Athul24milu/ESPFC-WHOOP-/02_Guides/ESP_FPV_ATHUL_Component_Map_L4.pdf

# TOP ASSEMBLY / ALL COMPONENTS

## 23 FOOTPRINTS ON THIS SIDE

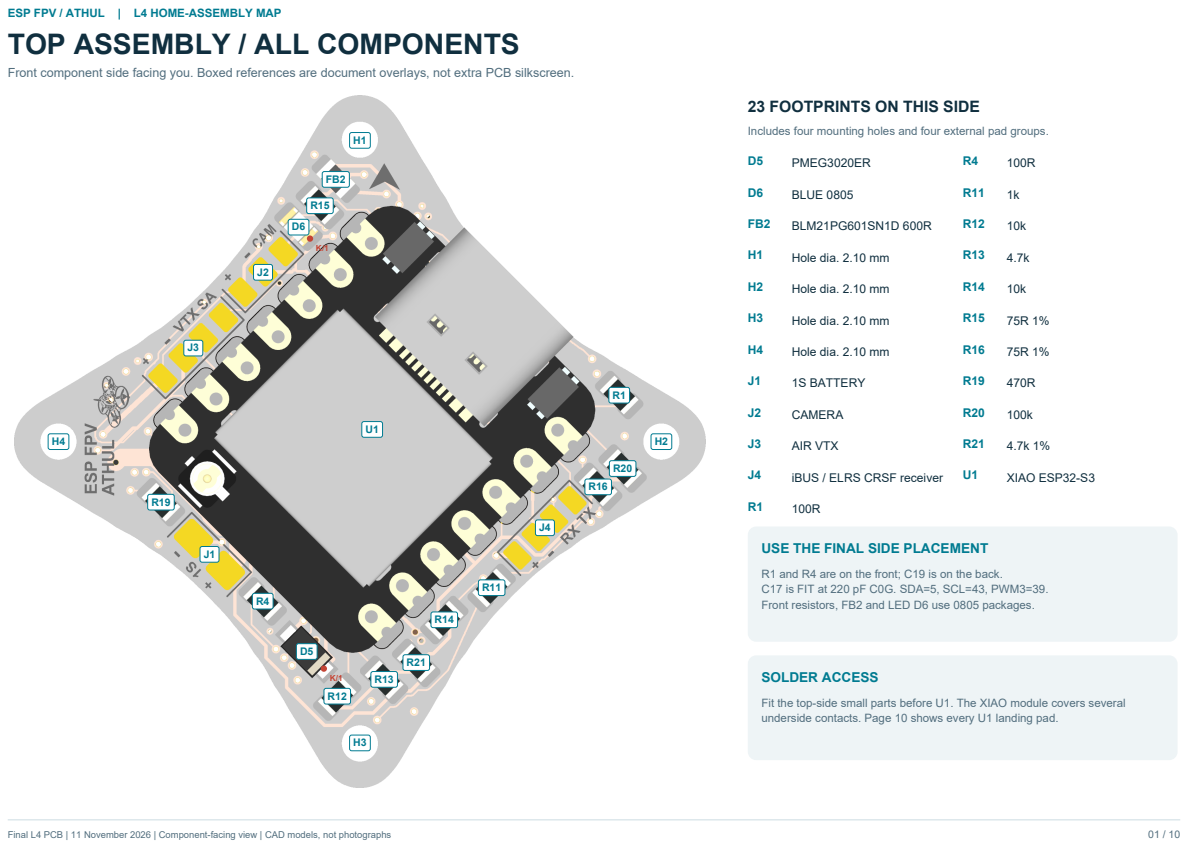
[picture p2: page 1]

ESP FPV / ATHUL | L4 HOME-ASSEMBLY MAP

Front component side facing you. Boxed references are document overlays, not extra PCB silkscreen.

Includes four mounting holes and four external pad groups.

USE THE FINAL SIDE PLACEMENT

R1 and R4 are on the front; C19 is on the back.
C17 is FIT at 220 pF C0G. SDA=5, SCL=43, PWM3=39.
Front resistors, FB2 and LED D6 use 0805 packages.

Fit the top-side small parts before U1. The XIAO module covers several
underside contacts. Page 10 shows every U1 landing pad.

# BOTTOM ASSEMBLY / ALL COMPONENTS

## 52 FOOTPRINTS ON THIS SIDE

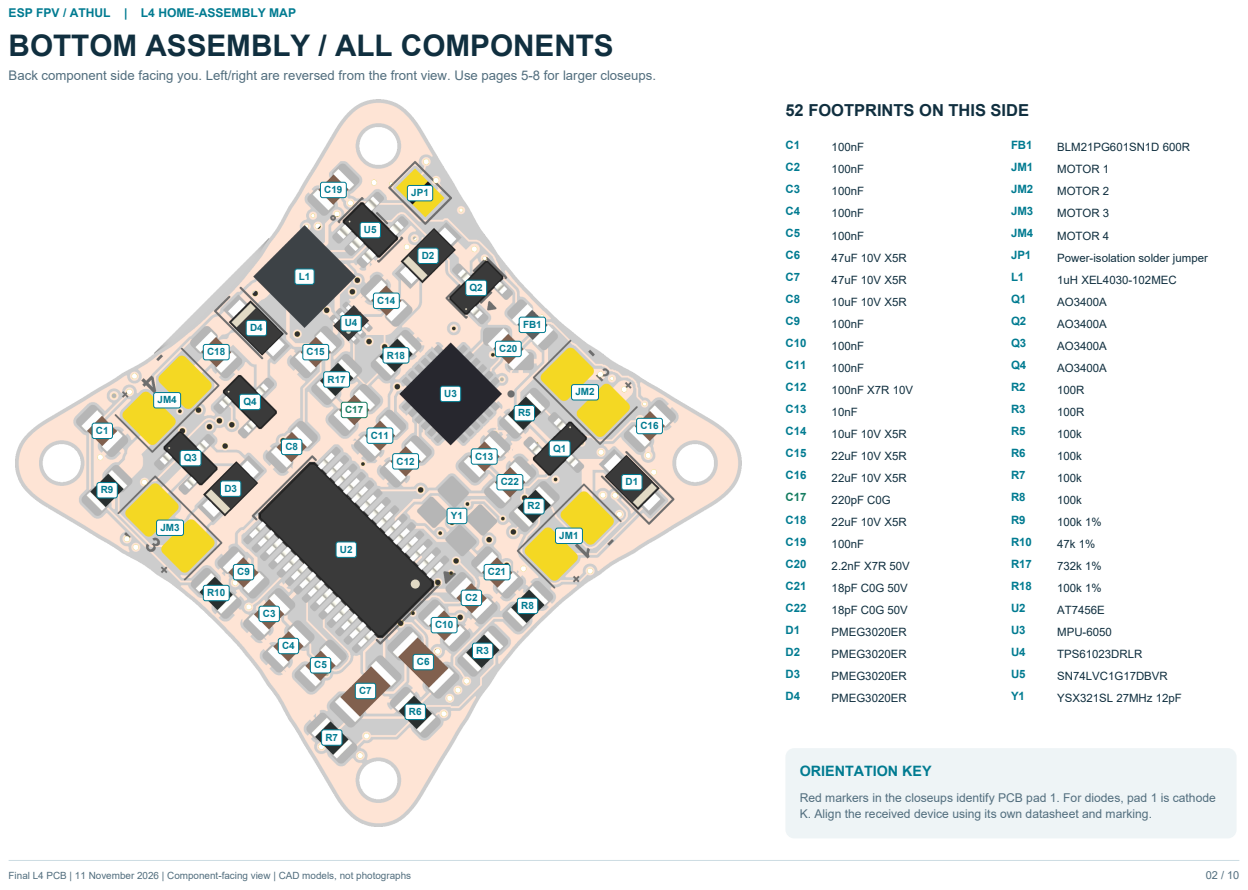
[picture p3: page 2]

Back component side facing you. Left/right are reversed from the front view. Use pages 5-8 for larger closeups.

Red markers in the closeups identify PCB pad 1. For diodes, pad 1 is cathode
K. Align the received device using its own datasheet and marking.

# BATTERY, CAMERA, VTX & RECEIVER / EXACT PADS

Front side facing you. Follow each colored leader to the center of the named pad.

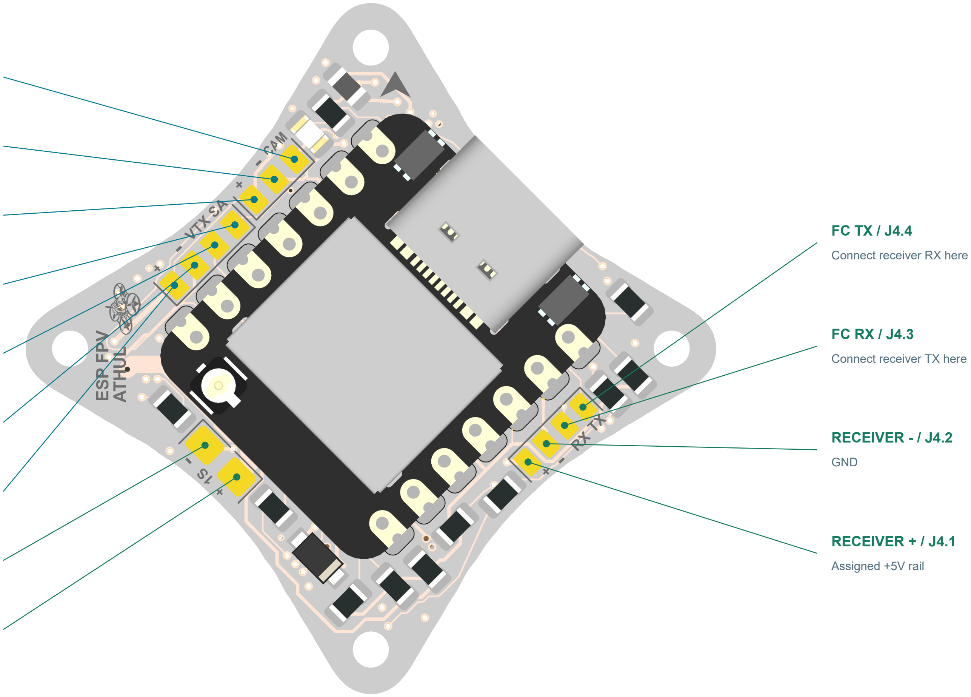
[picture p4: figure]
Connect receiver RX here; Connect receiver TX here; RECEIVER - / J4.2; GND; RECEIVER + / J4.1; Assigned +5V rail

Final L4 PCB | 11 November 2026 | Component-facing view | CAD models, not photographs | 03 / 10

CAM VIDEO / J2.3

Camera video -> OSD input

CAM - / J2.2

GND

CAM + / J2.1

Assigned +5V rail

SA / J3.4

SmartAudio

VTX VIDEO / J3.3

OSD video output

VTX - / J3.2

GND

VTX + / J3.1

Assigned +5V rail

BATTERY - / J1.2

GND

BATTERY + / J1.1

1S input / VBAT

POWER AND UART

J1 takes the 1S battery. J2/J3/J4 positive pads are on the regulated +5V rail: use 5V-compatible modules. Receiver TX -> FC RX, receiver RX -> FC TX. Battery disconnected for initial USB programming.

# MOTORS & POWER JUMPER / EXACT PADS

Back side facing you. Motor negative is a switched MOSFET return - it is not GND.

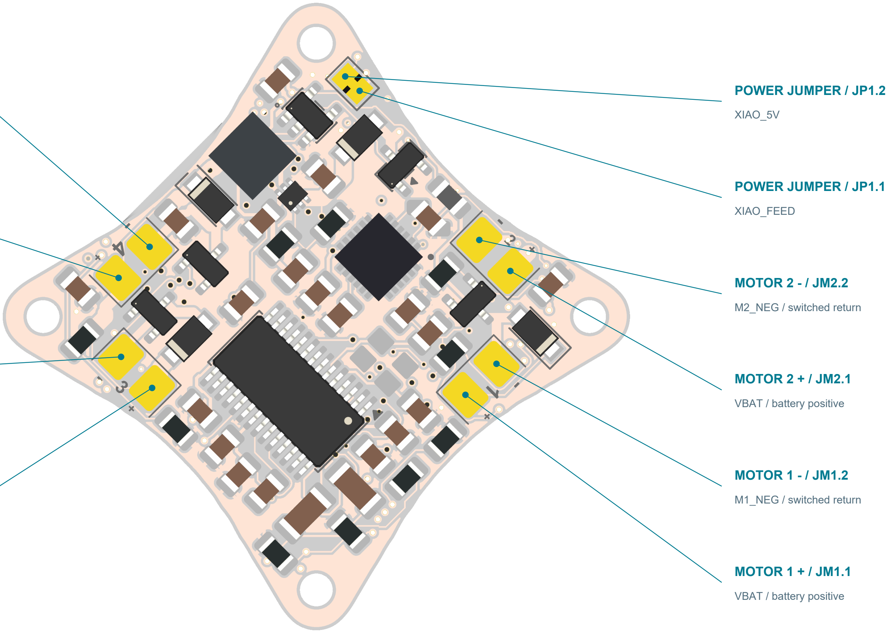
[picture p5: figure]
POWER JUMPER / JP1.2; XIAO_5V; POWER JUMPER / JP1.1; XIAO_FEED; MOTOR 2 - / JM2.2; M2_NEG / switched return; MOTOR 2 + / JM2.1; VBAT / battery positive; MOTOR 1 - / JM1.2; M1_NEG / switched return; MOTOR 1 + / JM1.1

Final L4 PCB | 11 November 2026 | Component-facing view | CAD models, not photographs | 04 / 10

MOTOR 4 - / JM4.2

M4_NEG / switched return

MOTOR 4 + / JM4.1

VBAT / battery positive

MOTOR 3 - / JM3.2

M3_NEG / switched return

MOTOR 3 + / JM3.1

VBAT / battery positive

JP1 AND MOTOR NUMBERING

JP1 is closed for battery flight operation; open it for simultaneous USB + battery use as marked in the design. Verify its bridge state with continuity. Motor numbers are PCB labels; the firmware mixer and spin directions still need setup.

# BOTTOM CLOSEUP / UPPER LEFT

## 14 REFERENCES IN THIS REGION

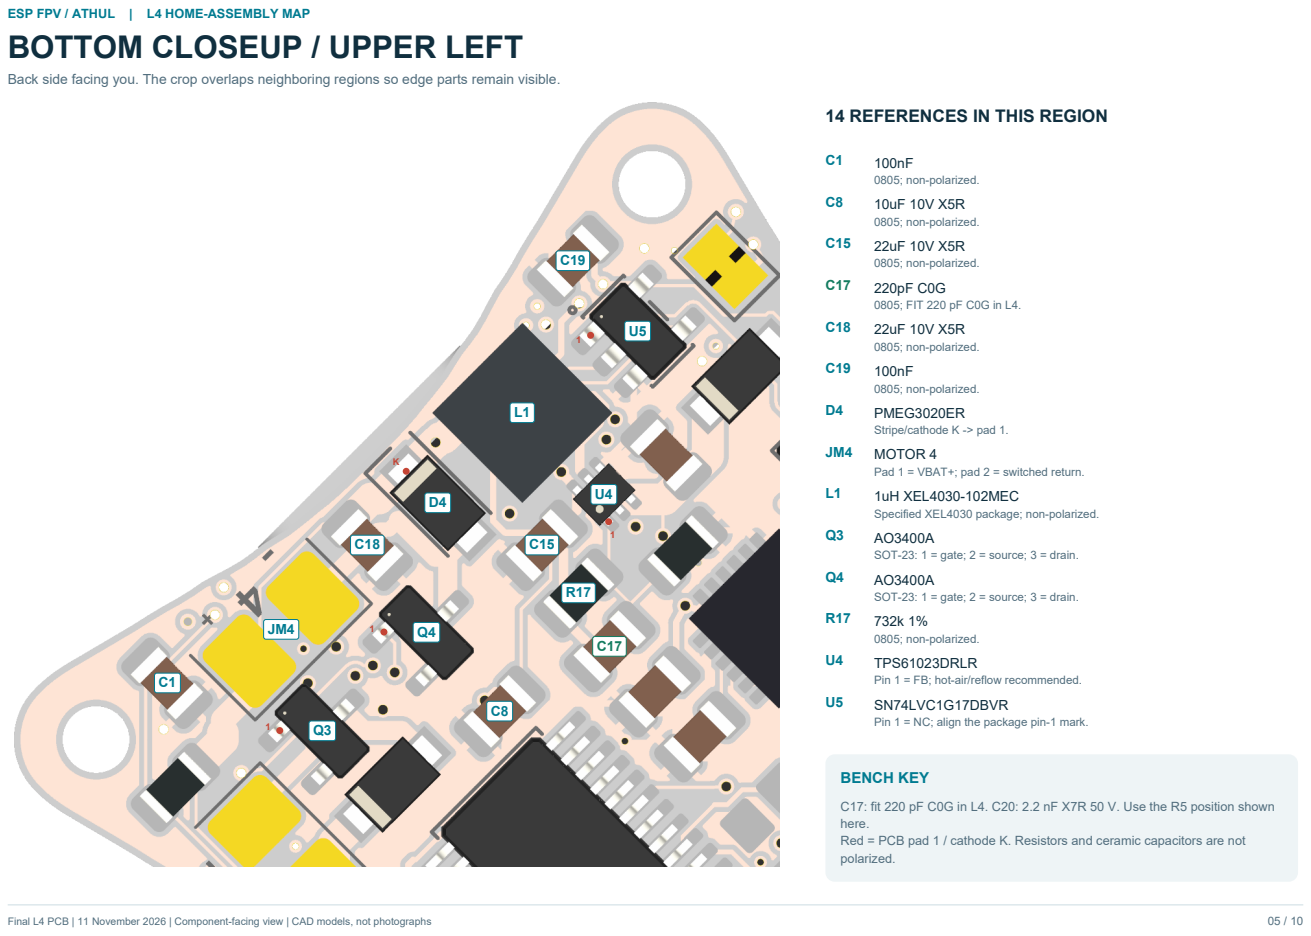
[picture p6: page 5]

Back side facing you. The crop overlaps neighboring regions so edge parts remain visible.

Pad 1 = VBAT+; pad 2 = switched return.

Specified XEL4030 package; non-polarized.

SOT-23: 1 = gate; 2 = source; 3 = drain.

Pin 1 = FB; hot-air/reflow recommended.

Pin 1 = NC; align the package pin-1 mark.

C17: fit 220 pF C0G in L4. C20: 2.2 nF X7R 50 V. Use the R5 position shown
here.
Red = PCB pad 1 / cathode K. Resistors and ceramic capacitors are not
polarized.

# BOTTOM CLOSEUP / UPPER RIGHT

## 15 REFERENCES IN THIS REGION

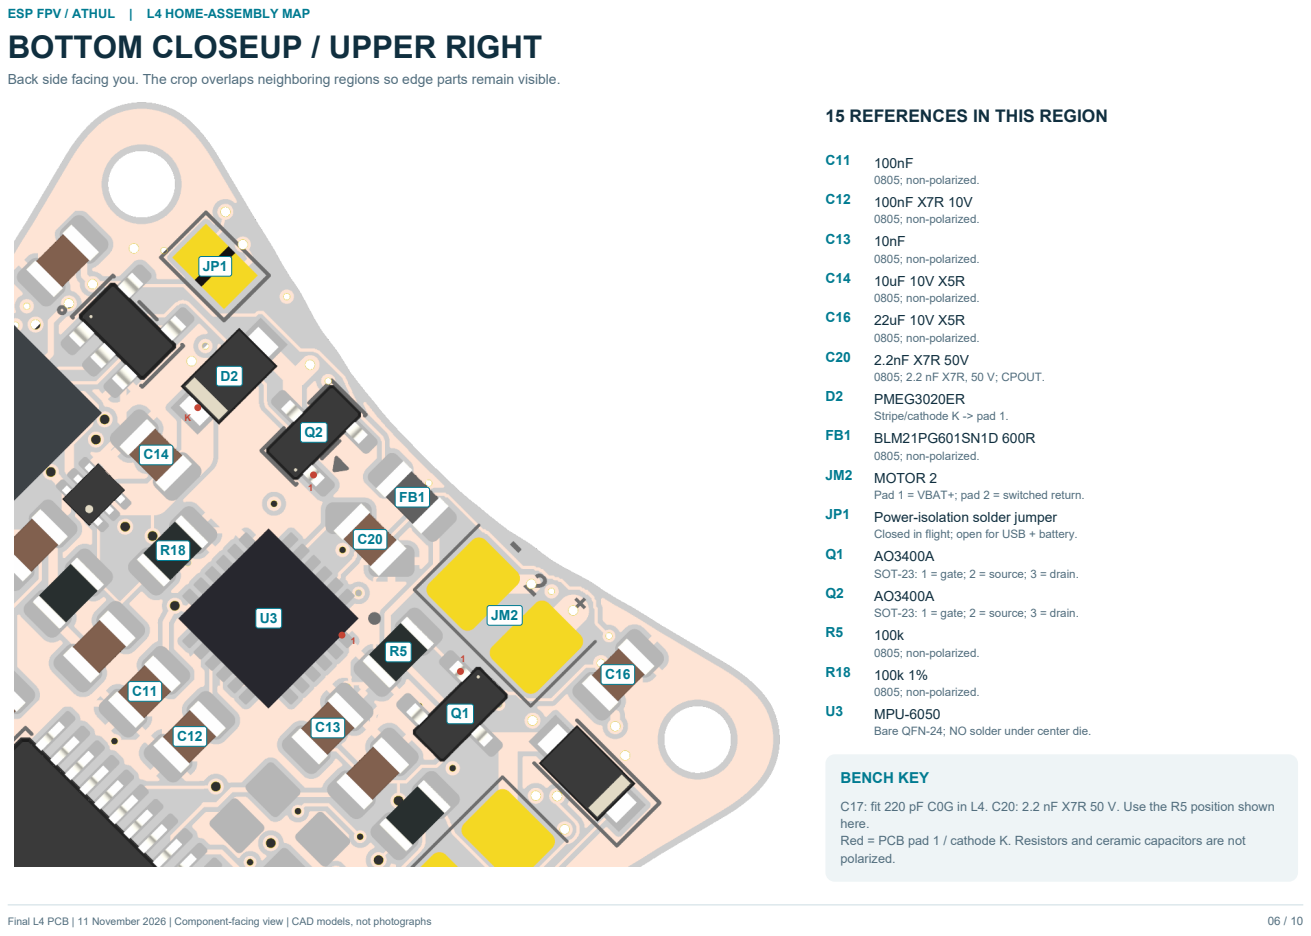
[picture p7: page 6]

Back side facing you. The crop overlaps neighboring regions so edge parts remain visible.

Pad 1 = VBAT+; pad 2 = switched return.

Closed in flight; open for USB + battery.

SOT-23: 1 = gate; 2 = source; 3 = drain.

Bare QFN-24; NO solder under center die.

C17: fit 220 pF C0G in L4. C20: 2.2 nF X7R 50 V. Use the R5 position shown
here.
Red = PCB pad 1 / cathode K. Resistors and ceramic capacitors are not
polarized.

# BOTTOM CLOSEUP / LOWER LEFT

## 11 REFERENCES IN THIS REGION

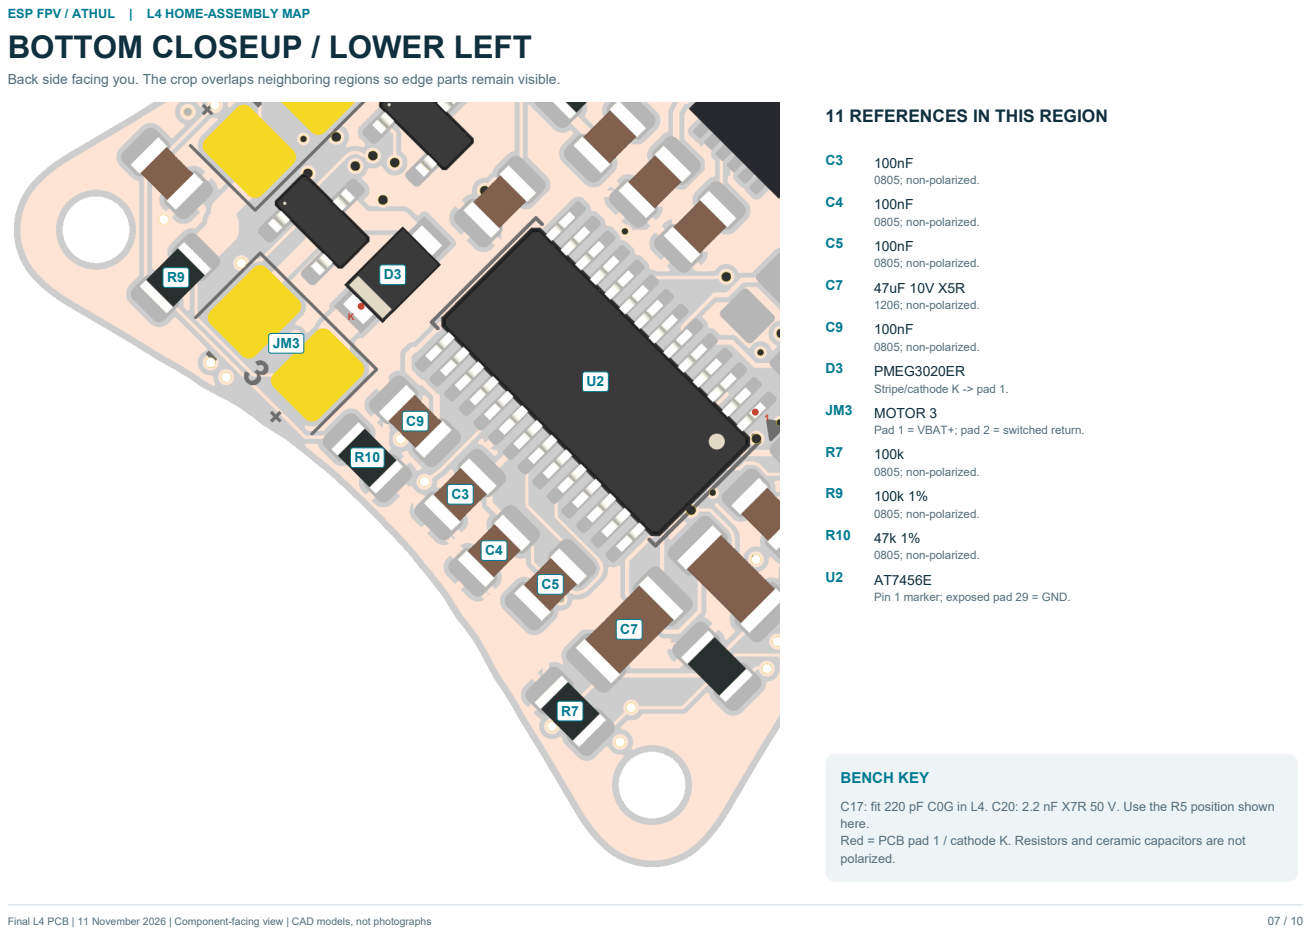
[picture p8: page 7]

Back side facing you. The crop overlaps neighboring regions so edge parts remain visible.

Pad 1 = VBAT+; pad 2 = switched return.

Pin 1 marker; exposed pad 29 = GND.

C17: fit 220 pF C0G in L4. C20: 2.2 nF X7R 50 V. Use the R5 position shown
here.
Red = PCB pad 1 / cathode K. Resistors and ceramic capacitors are not
polarized.

# BOTTOM CLOSEUP / LOWER RIGHT

## 12 REFERENCES IN THIS REGION

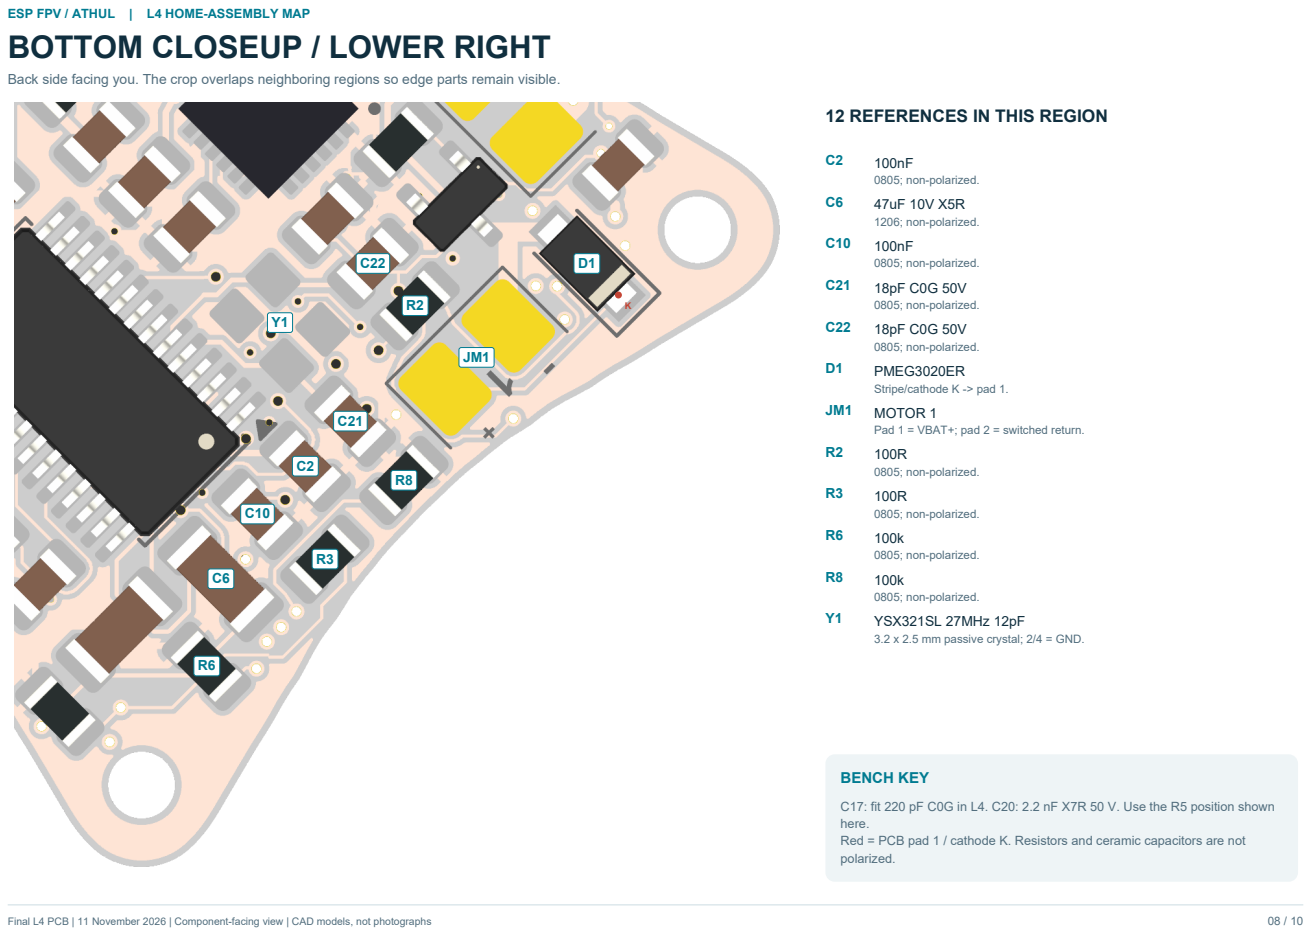
[picture p9: page 8]

Back side facing you. The crop overlaps neighboring regions so edge parts remain visible.

Pad 1 = VBAT+; pad 2 = switched return.

3.2 x 2.5 mm passive crystal; 2/4 = GND.

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

# ORIENTATION / ALIGN THE REAL PACKAGE

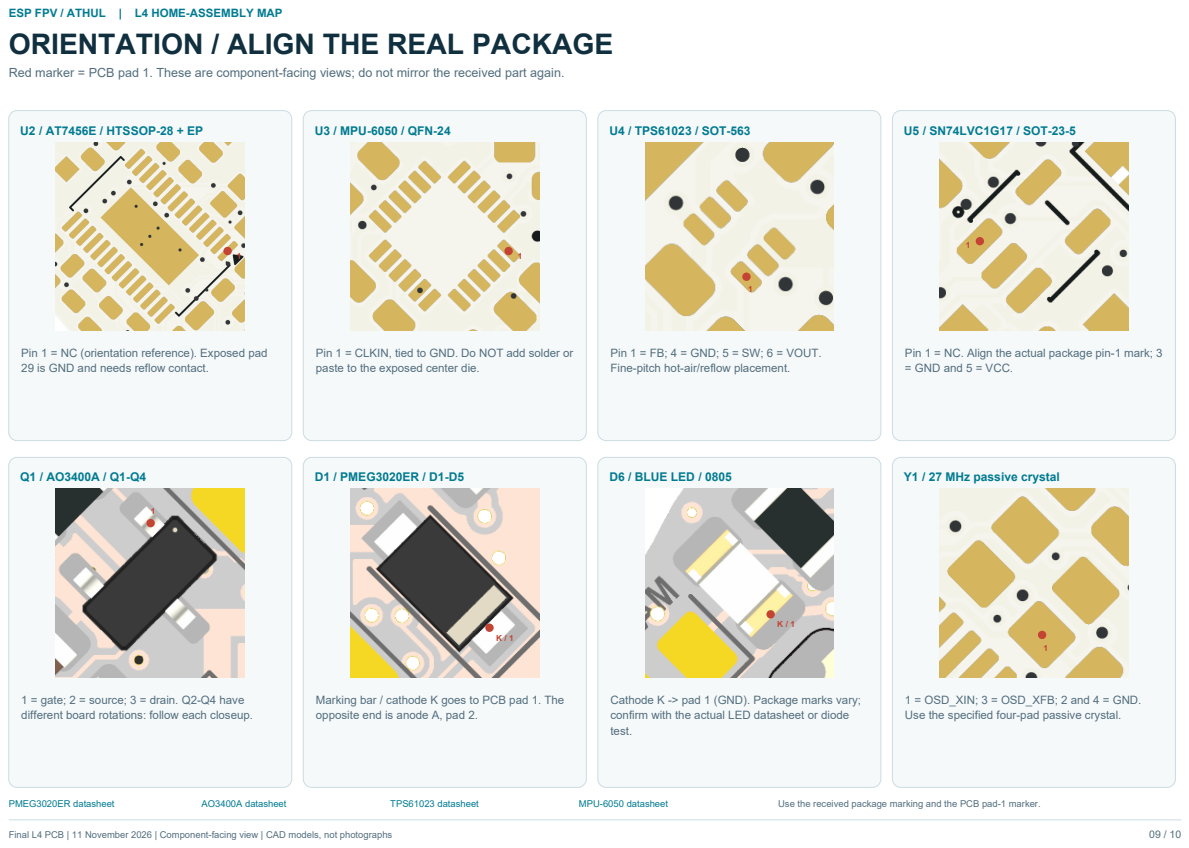
[picture p10: page 9]

Red marker = PCB pad 1. These are component-facing views; do not mirror the received part again.

Pin 1 = NC (orientation reference). Exposed pad
29 is GND and needs reflow contact.

Pin 1 = CLKIN, tied to GND. Do NOT add solder or
paste to the exposed center die.

Pin 1 = FB; 4 = GND; 5 = SW; 6 = VOUT.
Fine-pitch hot-air/reflow placement.

Pin 1 = NC. Align the actual package pin-1 mark; 3
= GND and 5 = VCC.

1 = gate; 2 = source; 3 = drain. Q2-Q4 have
different board rotations: follow each closeup.

Marking bar / cathode K goes to PCB pad 1. The
opposite end is anode A, pad 2.

Cathode K -> pad 1 (GND). Package marks vary;
confirm with the actual LED datasheet or diode
test.

1 = OSD_XIN; 3 = OSD_XFB; 2 and 4 = GND.
Use the specified four-pad passive crystal.

# XIAO CONTACTS / SOLDER BEFORE THE MODULE HIDES THEM

## U1 PAD / SIGNAL KEY

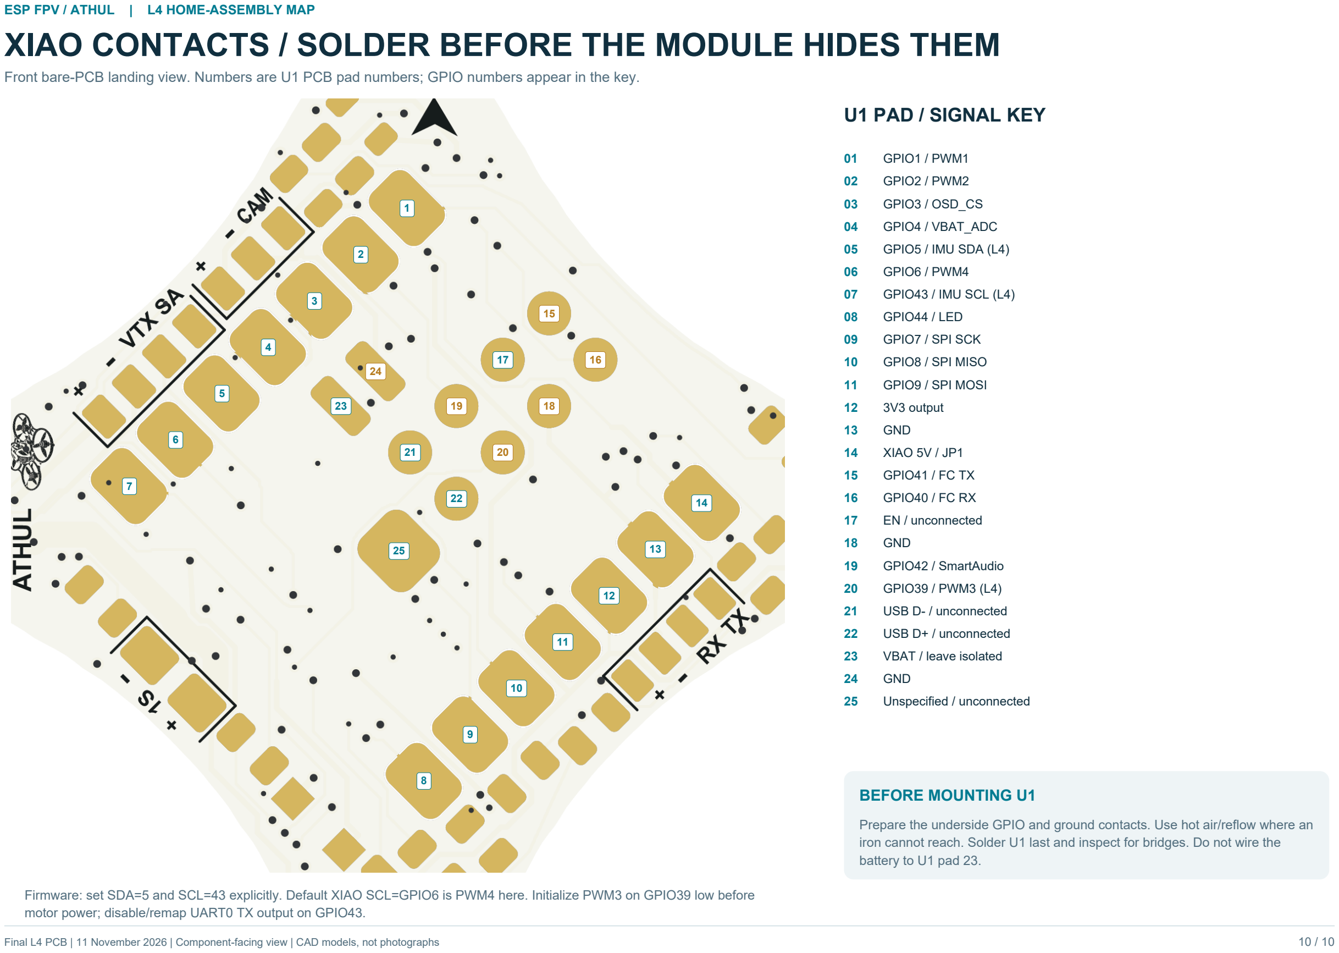
[picture p11: page 10]

Front bare-PCB landing view. Numbers are U1 PCB pad numbers; GPIO numbers appear in the key.

Final L4 PCB | 11 November 2026 | Component-facing view | CAD models, not photographs | 10 / 10

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
17 16

19 18

21 20

22

23

24

25

### 01 GPIO1 / PWM1

### 02 GPIO2 / PWM2

### 03 GPIO3 / OSD_CS

### 04 GPIO4 / VBAT_ADC

### 05 GPIO5 / IMU SDA (L4)

### 06 GPIO6 / PWM4

### 07 GPIO43 / IMU SCL (L4)

### 08 GPIO44 / LED

### 09 GPIO7 / SPI SCK

### 10 GPIO8 / SPI MISO

### 11 GPIO9 / SPI MOSI

12 3V3 output

### 13 GND

### 14 XIAO 5V / JP1

### 15 GPIO41 / FC TX

### 16 GPIO40 / FC RX

### 17 EN / unconnected

### 18 GND

### 19 GPIO42 / SmartAudio

### 20 GPIO39 / PWM3 (L4)

### 21 USB D- / unconnected

### 22 USB D+ / unconnected

### 23 VBAT / leave isolated

### 24 GND

### 25 Unspecified / unconnected

BEFORE MOUNTING U1

Prepare the underside GPIO and ground contacts. Use hot air/reflow where an iron cannot reach. Solder U1 last and inspect for bridges. Do not wire the battery to U1 pad 23.

Firmware: set SDA=5 and SCL=43 explicitly. Default XIAO SCL=GPIO6 is PWM4 here. Initialize PWM3 on GPIO39 low before motor power; disable/remap UART0 TX output on GPIO43.
