Athul24milu/ESPFC-WHOOP-/03_BOM_and_Purchase/ESP_FC_L2_BOM_All_75_References.csv

Reference | Qty per FC | Value | Package | Side | Fit | Purchase status | Product or catalogue link | Robu search | Quartz search | Evelta search | Notes | Data date
C1 | 1 | 100nF | 0805 | bottom | FIT | Matching listing found; confirm stock at checkout | https://quartzcomponents.com/products/kemet-100nf-50v-0805-smd-pack-x7r-multilayer-ceramic-capacitor-10-tolerence-pack-of-20 | https://robu.in/?s=100nF%200805&post_type=product | https://quartzcomponents.com/search?q=100nF%200805&type=product | https://evelta.com/search.php?search_query=100nF%200805 | Ceramic, non-polarized. Use X7R, >=10V (50V acceptable). | 2026-11-10
C2 | 1 | 100nF | 0805 | bottom | FIT | Matching listing found; confirm stock at checkout | https://quartzcomponents.com/products/kemet-100nf-50v-0805-smd-pack-x7r-multilayer-ceramic-capacitor-10-tolerence-pack-of-20 | https://robu.in/?s=100nF%200805&post_type=product | https://quartzcomponents.com/search?q=100nF%200805&type=product | https://evelta.com/search.php?search_query=100nF%200805 | Ceramic, non-polarized. Use X7R, >=10V (50V acceptable). | 2026-11-10
C3 | 1 | 100nF | 0805 | bottom | FIT | Matching listing found; confirm stock at checkout | https://quartzcomponents.com/products/kemet-100nf-50v-0805-smd-pack-x7r-multilayer-ceramic-capacitor-10-tolerence-pack-of-20 | https://robu.in/?s=100nF%200805&post_type=product | https://quartzcomponents.com/search?q=100nF%200805&type=product | https://evelta.com/search.php?search_query=100nF%200805 | Ceramic, non-polarized. Use X7R, >=10V (50V acceptable). | 2026-11-10
C4 | 1 | 100nF | 0805 | bottom | FIT | Matching listing found; confirm stock at checkout | https://quartzcomponents.com/products/kemet-100nf-50v-0805-smd-pack-x7r-multilayer-ceramic-capacitor-10-tolerence-pack-of-20 | https://robu.in/?s=100nF%200805&post_type=product | https://quartzcomponents.com/search?q=100nF%200805&type=product | https://evelta.com/search.php?search_query=100nF%200805 | Ceramic, non-polarized. Use X7R, >=10V (50V acceptable). | 2026-11-10
C5 | 1 | 100nF | 0805 | bottom | FIT | Matching listing found; confirm stock at checkout | https://quartzcomponents.com/products/kemet-100nf-50v-0805-smd-pack-x7r-multilayer-ceramic-capacitor-10-tolerence-pack-of-20 | https://robu.in/?s=100nF%200805&post_type=product | https://quartzcomponents.com/search?q=100nF%200805&type=product | https://evelta.com/search.php?search_query=100nF%200805 | Ceramic, non-polarized. Use X7R, >=10V (50V acceptable). | 2026-11-10
C6 | 1 | 47uF 10V X5R | 1206 | bottom | FIT | Search links only; exact orderable SKU not confirmed |  | https://robu.in/?s=47uF%2010V%20X5R%201206&post_type=product | https://quartzcomponents.com/search?q=47uF%2010V%20X5R%201206&type=product | https://evelta.com/search.php?search_query=47uF%2010V%20X5R%201206 | Ceramic, non-polarized. Match dielectric and voltage shown; check effective capacitance under bias. | 2026-11-10
C7 | 1 | 47uF 10V X5R | 1206 | bottom | FIT | Search links only; exact orderable SKU not confirmed |  | https://robu.in/?s=47uF%2010V%20X5R%201206&post_type=product | https://quartzcomponents.com/search?q=47uF%2010V%20X5R%201206&type=product | https://evelta.com/search.php?search_query=47uF%2010V%20X5R%201206 | Ceramic, non-polarized. Match dielectric and voltage shown; check effective capacitance under bias. | 2026-11-10
C8 | 1 | 10uF 10V X5R | 0805 | bottom | FIT | Search links only; exact orderable SKU not confirmed |  | https://robu.in/?s=10uF%2010V%20X5R%200805&post_type=product | https://quartzcomponents.com/search?q=10uF%2010V%20X5R%200805&type=product | https://evelta.com/search.php?search_query=10uF%2010V%20X5R%200805 | Ceramic, non-polarized. Match dielectric and voltage shown; check effective capacitance under bias. | 2026-11-10
C9 | 1 | 100nF | 0805 | bottom | FIT | Matching listing found; confirm stock at checkout | https://quartzcomponents.com/products/kemet-100nf-50v-0805-smd-pack-x7r-multilayer-ceramic-capacitor-10-tolerence-pack-of-20 | https://robu.in/?s=100nF%200805&post_type=product | https://quartzcomponents.com/search?q=100nF%200805&type=product | https://evelta.com/search.php?search_query=100nF%200805 | Ceramic, non-polarized. Use X7R, >=10V (50V acceptable). | 2026-11-10
C10 | 1 | 100nF | 0805 | bottom | FIT | Matching listing found; confirm stock at checkout | https://quartzcomponents.com/products/kemet-100nf-50v-0805-smd-pack-x7r-multilayer-ceramic-capacitor-10-tolerence-pack-of-20 | https://robu.in/?s=100nF%200805&post_type=product | https://quartzcomponents.com/search?q=100nF%200805&type=product | https://evelta.com/search.php?search_query=100nF%200805 | Ceramic, non-polarized. Use X7R, >=10V (50V acceptable). | 2026-11-10
C11 | 1 | 100nF | 0805 | bottom | FIT | Matching listing found; confirm stock at checkout | https://quartzcomponents.com/products/kemet-100nf-50v-0805-smd-pack-x7r-multilayer-ceramic-capacitor-10-tolerence-pack-of-20 | https://robu.in/?s=100nF%200805&post_type=product | https://quartzcomponents.com/search?q=100nF%200805&type=product | https://evelta.com/search.php?search_query=100nF%200805 | Ceramic, non-polarized. Use X7R, >=10V (50V acceptable). | 2026-11-10
C12 | 1 | 100nF X7R 10V | 0805 | bottom | FIT | Search links only; exact orderable SKU not confirmed |  | https://robu.in/?s=100nF%20X7R%2010V%200805&post_type=product | https://quartzcomponents.com/search?q=100nF%20X7R%2010V%200805&type=product | https://evelta.com/search.php?search_query=100nF%20X7R%2010V%200805 | Ceramic, non-polarized. Use X7R, >=10V (50V acceptable). | 2026-11-10
C13 | 1 | 10nF | 0805 | bottom | FIT | Search links only; exact orderable SKU not confirmed |  | https://robu.in/?s=10nF%200805&post_type=product | https://quartzcomponents.com/search?q=10nF%200805&type=product | https://evelta.com/search.php?search_query=10nF%200805 | Ceramic, non-polarized. Use X7R, >=10V (50V acceptable). | 2026-11-10
C14 | 1 | 10uF 10V X5R | 0805 | bottom | FIT | Search links only; exact orderable SKU not confirmed |  | https://robu.in/?s=10uF%2010V%20X5R%200805&post_type=product | https://quartzcomponents.com/search?q=10uF%2010V%20X5R%200805&type=product | https://evelta.com/search.php?search_query=10uF%2010V%20X5R%200805 | Ceramic, non-polarized. Match dielectric and voltage shown; check effective capacitance under bias. | 2026-11-10
C15 | 1 | 22uF 10V X5R | 0805 | bottom | FIT | Search links only; exact orderable SKU not confirmed |  | https://robu.in/?s=22uF%2010V%20X5R%200805&post_type=product | https://quartzcomponents.com/search?q=22uF%2010V%20X5R%200805&type=product | https://evelta.com/search.php?search_query=22uF%2010V%20X5R%200805 | Ceramic, non-polarized. Match dielectric and voltage shown; check effective capacitance under bias. | 2026-11-10
C16 | 1 | 22uF 10V X5R | 0805 | bottom | FIT | Search links only; exact orderable SKU not confirmed |  | https://robu.in/?s=22uF%2010V%20X5R%200805&post_type=product | https://quartzcomponents.com/search?q=22uF%2010V%20X5R%200805&type=product | https://evelta.com/search.php?search_query=22uF%2010V%20X5R%200805 | Ceramic, non-polarized. Match dielectric and voltage shown; check effective capacitance under bias. | 2026-11-10
C17 | 1 | 220pF C0G | 0805 | bottom | FIT | C0G 220pF listing found in Quartz catalogue; confirm stock | https://quartzcomponents.com/collections/smd-capacitors?page=3 | https://robu.in/?s=220pF%20C0G%200805&post_type=product | https://quartzcomponents.com/search?q=220pF%20C0G%200805&type=product | https://evelta.com/search.php?search_query=220pF%20C0G%200805 | FIT in L2, 0805 220pF C0G/NP0; NOT DNP. Catalogue link, not a direct item page. | 2026-11-10
C18 | 1 | 22uF 10V X5R | 0805 | bottom | FIT | Search links only; exact orderable SKU not confirmed |  | https://robu.in/?s=22uF%2010V%20X5R%200805&post_type=product | https://quartzcomponents.com/search?q=22uF%2010V%20X5R%200805&type=product | https://evelta.com/search.php?search_query=22uF%2010V%20X5R%200805 | Ceramic, non-polarized. Match dielectric and voltage shown; check effective capacitance under bias. | 2026-11-10
C19 | 1 | 100nF | 0805 | bottom | FIT | Matching listing found; confirm stock at checkout | https://quartzcomponents.com/products/kemet-100nf-50v-0805-smd-pack-x7r-multilayer-ceramic-capacitor-10-tolerence-pack-of-20 | https://robu.in/?s=100nF%200805&post_type=product | https://quartzcomponents.com/search?q=100nF%200805&type=product | https://evelta.com/search.php?search_query=100nF%200805 | Ceramic, non-polarized. Use X7R, >=10V (50V acceptable). | 2026-11-10
C20 | 1 | 2.2nF X7R 50V | 0805 | bottom | FIT | Prior product candidate; current stock unconfirmed | https://quartzcomponents.com/products/kemet-2-2nf-50v-805-smd-pack-c0g-multilayer-ceramic-capacitor-10-tolerence-pack-of-20 | https://robu.in/?s=2.2nF%20X7R%2050V%200805&post_type=product | https://quartzcomponents.com/search?q=2.2nF%20X7R%2050V%200805&type=product | https://evelta.com/search.php?search_query=2.2nF%20X7R%2050V%200805 | 0805 2.2nF X7R 50V; Kemet C0805C222K5RACTU. URL says C0G: require shipped MPN/dielectric confirmation. | 2026-11-10
C21 | 1 | 18pF C0G 50V | 0805 | bottom | FIT | Prior product candidate; current stock unconfirmed | https://robu.in/product/c0805c180j5gactu-kemet-smd-multilayer-ceramic-capacitor-18-pf-50-v-0805-2012-metric-%C2%B1-5-c0g-np0-c-series-kemet/ | https://robu.in/?s=18pF%20C0G%2050V%200805&post_type=product | https://quartzcomponents.com/search?q=18pF%20C0G%2050V%200805&type=product | https://evelta.com/search.php?search_query=18pF%20C0G%2050V%200805 | 0805 18pF C0G/NP0 50V; C0805C180J5GACTU candidate; crystal startup must be measured. | 2026-11-10
C22 | 1 | 18pF C0G 50V | 0805 | bottom | FIT | Prior product candidate; current stock unconfirmed | https://robu.in/product/c0805c180j5gactu-kemet-smd-multilayer-ceramic-capacitor-18-pf-50-v-0805-2012-metric-%C2%B1-5-c0g-np0-c-series-kemet/ | https://robu.in/?s=18pF%20C0G%2050V%200805&post_type=product | https://quartzcomponents.com/search?q=18pF%20C0G%2050V%200805&type=product | https://evelta.com/search.php?search_query=18pF%20C0G%2050V%200805 | 0805 18pF C0G/NP0 50V; C0805C180J5GACTU candidate; crystal startup must be measured. | 2026-11-10
D1 | 1 | PMEG3020ER | Nexperia_CFP3_SOD-123W_Compact | bottom | FIT | Search links only; exact orderable SKU not confirmed |  | https://robu.in/?s=PMEG3020ER%20Nexperia_CFP3_SOD-123W_Compact&post_type=product | https://quartzcomponents.com/search?q=PMEG3020ER%20Nexperia_CFP3_SOD-123W_Compact&type=product | https://evelta.com/search.php?search_query=PMEG3020ER%20Nexperia_CFP3_SOD-123W_Compact | Nexperia PMEG3020ER CFP3/SOD-123W; cathode pad1. Do not substitute another manufacturer/package just because name is similar. | 2026-11-10
D2 | 1 | PMEG3020ER | RevK_Assembly_D2 | bottom | FIT | Search links only; exact orderable SKU not confirmed |  | https://robu.in/?s=PMEG3020ER%20RevK_Assembly_D2&post_type=product | https://quartzcomponents.com/search?q=PMEG3020ER%20RevK_Assembly_D2&type=product | https://evelta.com/search.php?search_query=PMEG3020ER%20RevK_Assembly_D2 | Nexperia PMEG3020ER CFP3/SOD-123W; cathode pad1. Do not substitute another manufacturer/package just because name is similar. | 2026-11-10
D3 | 1 | PMEG3020ER | Nexperia_CFP3_SOD-123W_Compact_Assembly | bottom | FIT | Search links only; exact orderable SKU not confirmed |  | https://robu.in/?s=PMEG3020ER%20Nexperia_CFP3_SOD-123W_Compact_Assembly&post_type=product | https://quartzcomponents.com/search?type=product | https://evelta.com/search.php?search_query=PMEG3020ER%20Nexperia_CFP3_SOD-123W_Compact_Assembly | Nexperia PMEG3020ER CFP3/SOD-123W; cathode pad1. Do not substitute another manufacturer/package just because name is similar. | 2026-11-10
D4 | 1 | PMEG3020ER | Nexperia_CFP3_SOD-123W_CurvedEdge | bottom | FIT | Search links only; exact orderable SKU not confirmed |  | https://robu.in/?s=PMEG3020ER%20Nexperia_CFP3_SOD-123W_CurvedEdge&post_type=product | https://quartzcomponents.com/search?q=PMEG3020ER%20Nexperia_CFP3_SOD-123W_CurvedEdge&type=product | https://evelta.com/search.php?search_query=PMEG3020ER%20Nexperia_CFP3_SOD-123W_CurvedEdge | Nexperia PMEG3020ER CFP3/SOD-123W; cathode pad1. Do not substitute another manufacturer/package just because name is similar. | 2026-11-10
D5 | 1 | PMEG3020ER | RevK_Assembly_D5 | top | FIT | Search links only; exact orderable SKU not confirmed |  | https://robu.in/?s=PMEG3020ER%20RevK_Assembly_D5&post_type=product | https://quartzcomponents.com/search?q=PMEG3020ER%20RevK_Assembly_D5&type=product | https://evelta.com/search.php?search_query=PMEG3020ER%20RevK_Assembly_D5 | Nexperia PMEG3020ER CFP3/SOD-123W; cathode pad1. Do not substitute another manufacturer/package just because name is similar. | 2026-11-10
D6 | 1 | BLUE 0805 | 0805 | top | FIT | Search links only; exact orderable SKU not confirmed |  | https://robu.in/?s=BLUE%200805%200805&post_type=product | https://quartzcomponents.com/search?q=BLUE%200805%200805&type=product | https://evelta.com/search.php?search_query=BLUE%200805%200805 | Match value, package and rating before ordering. Stock and prices are not guaranteed. | 2026-11-10
FB1 | 1 | BLM21PG601SN1D 600R | 0805 | bottom | FIT | Search links only; exact orderable SKU not confirmed |  | https://robu.in/?s=BLM21PG601SN1D%20600R%200805&post_type=product | https://quartzcomponents.com/search?q=BLM21PG601SN1D%20600R%200805&type=product | https://evelta.com/search.php?search_query=BLM21PG601SN1D%20600R%200805 | Match value, package and rating before ordering. Stock and prices are not guaranteed. | 2026-11-10
FB2 | 1 | BLM21PG601SN1D 600R | 0805 | top | FIT | Search links only; exact orderable SKU not confirmed |  | https://robu.in/?s=BLM21PG601SN1D%20600R%200805&post_type=product | https://quartzcomponents.com/search?q=BLM21PG601SN1D%20600R%200805&type=product | https://evelta.com/search.php?search_query=BLM21PG601SN1D%20600R%200805 | Match value, package and rating before ordering. Stock and prices are not guaranteed. | 2026-11-10
H1 | 1 | Mounting hole 2.1mm | Hole_2p1mm_3p6Head | top | PCB feature | PCB feature; no component purchase |  |  |  |  | Mounting hole: use insulating M2 hardware. | 2026-11-10
H2 | 1 | Mounting hole 2.1mm | Hole_2p1mm_3p6Head | top | PCB feature | PCB feature; no component purchase |  |  |  |  | Mounting hole: use insulating M2 hardware. | 2026-11-10
H3 | 1 | Mounting hole 2.1mm | Hole_2p1mm_3p6Head | top | PCB feature | PCB feature; no component purchase |  |  |  |  | Mounting hole: use insulating M2 hardware. | 2026-11-10
H4 | 1 | Mounting hole 2.1mm | Hole_2p1mm_3p6Head | top | PCB feature | PCB feature; no component purchase |  |  |  |  | Mounting hole: use insulating M2 hardware. | 2026-11-10
J1 | 1 | 1S BATTERY | Battery_Pads_2p6 | top | PCB feature | PCB feature; no component purchase |  |  |  |  | Integral solder pad/jumper; wires and solder supplied separately. | 2026-11-10
J2 | 1 | CAMERA | Camera_Pads_1p65 | top | PCB feature | PCB feature; no component purchase |  |  |  |  | Integral solder pad/jumper; wires and solder supplied separately. | 2026-11-10
J3 | 1 | AIR VTX | VTX_Pads_1p65 | top | PCB feature | PCB feature; no component purchase |  |  |  |  | Integral solder pad/jumper; wires and solder supplied separately. | 2026-11-10
J4 | 1 | iBUS / ELRS CRSF receiver | Receiver_Pads_1p5 | top | PCB feature | PCB feature; no component purchase |  |  |  |  | Integral solder pad/jumper; wires and solder supplied separately. | 2026-11-10
JM1 | 1 | MOTOR 1 | RevK_Assembly_JM1 | bottom | PCB feature | PCB feature; no component purchase |  |  |  |  | Integral solder pad/jumper; wires and solder supplied separately. | 2026-11-10
JM2 | 1 | MOTOR 2 | RevK_Assembly_JM2 | bottom | PCB feature | PCB feature; no component purchase |  |  |  |  | Integral solder pad/jumper; wires and solder supplied separately. | 2026-11-10
JM3 | 1 | MOTOR 3 | RevK_Assembly_JM3 | bottom | PCB feature | PCB feature; no component purchase |  |  |  |  | Integral solder pad/jumper; wires and solder supplied separately. | 2026-11-10
JM4 | 1 | MOTOR 4 | RevK_Assembly_JM4 | bottom | PCB feature | PCB feature; no component purchase |  |  |  |  | Integral solder pad/jumper; wires and solder supplied separately. | 2026-11-10
JP1 | 1 | CLOSED in flight / OPEN for USB + battery | SolderJumper-2_P1.3mm_Bridged_Pad1.0x1.5mm_Compact | bottom | PCB feature | PCB feature; no component purchase |  |  |  |  | Integral solder pad/jumper; wires and solder supplied separately. | 2026-11-10
L1 | 1 | 1uH XEL4030-102MEC | L_Coilcraft_XxL4030_Compact | bottom | FIT | Exact XEL4030 source requires confirmation |  | https://robu.in/?s=1uH%20XEL4030-102MEC%20L_Coilcraft_XxL4030_Compact&post_type=product | https://quartzcomponents.com/search?type=product | https://evelta.com/search.php?search_query=1uH%20XEL4030-102MEC%20L_Coilcraft_XxL4030_Compact | Board requires Coilcraft XEL4030-102MEC 1uH 4x4mm. Robu SKU R113961 title/MPN conflict (XFL4020-222MEC). Owned SWPA5040S1R5NT is NOT a confirmed drop-in replacement. | 2026-11-10
Q1 | 1 | AO3400A | RevK_Assembly_Q1 | bottom | FIT | CJ3400A substitute candidate; not approved automatically | https://evelta.com/cj3400a-mosfet-30v-5-8a-sot-23/ | https://robu.in/?s=AO3400A%20RevK_Assembly_Q1&post_type=product | https://quartzcomponents.com/search?q=AO3400A%20RevK_Assembly_Q1&type=product | https://evelta.com/search.php?search_query=AO3400A%20RevK_Assembly_Q1 | Board specifies AO3400A: pin1G,2S,3D. Confirm manufacturer/lot pinout and 3.3V gate characteristics. Robu AO3400-HXY has conflicting pinout: do not use blindly. Motor thermal validation pending. | 2026-11-10
Q2 | 1 | AO3400A | SOT-23_Compact | bottom | FIT | CJ3400A substitute candidate; not approved automatically | https://evelta.com/cj3400a-mosfet-30v-5-8a-sot-23/ | https://robu.in/?s=AO3400A%20SOT-23_Compact&post_type=product | https://quartzcomponents.com/search?q=AO3400A%20SOT-23_Compact&type=product | https://evelta.com/search.php?search_query=AO3400A%20SOT-23_Compact | Board specifies AO3400A: pin1G,2S,3D. Confirm manufacturer/lot pinout and 3.3V gate characteristics. Robu AO3400-HXY has conflicting pinout: do not use blindly. Motor thermal validation pending. | 2026-11-10
Q3 | 1 | AO3400A | SOT-23_Compact_Assembly | bottom | FIT | CJ3400A substitute candidate; not approved automatically | https://evelta.com/cj3400a-mosfet-30v-5-8a-sot-23/ | https://robu.in/?s=AO3400A%20SOT-23_Compact_Assembly&post_type=product | https://quartzcomponents.com/search?q=AO3400A%20SOT-23_Compact_Assembly&type=product | https://evelta.com/search.php?search_query=AO3400A%20SOT-23_Compact_Assembly | Board specifies AO3400A: pin1G,2S,3D. Confirm manufacturer/lot pinout and 3.3V gate characteristics. Robu AO3400-HXY has conflicting pinout: do not use blindly. Motor thermal validation pending. | 2026-11-10
Q4 | 1 | AO3400A | RevK_Assembly_Q4 | bottom | FIT | CJ3400A substitute candidate; not approved automatically | https://evelta.com/cj3400a-mosfet-30v-5-8a-sot-23/ | https://robu.in/?s=AO3400A%20RevK_Assembly_Q4&post_type=product | https://quartzcomponents.com/search?q=AO3400A%20RevK_Assembly_Q4&type=product | https://evelta.com/search.php?search_query=AO3400A%20RevK_Assembly_Q4 | Board specifies AO3400A: pin1G,2S,3D. Confirm manufacturer/lot pinout and 3.3V gate characteristics. Robu AO3400-HXY has conflicting pinout: do not use blindly. Motor thermal validation pending. | 2026-11-10
R1 | 1 | 100R | 0805 | top | FIT | Matching listing found; confirm stock at checkout | https://quartzcomponents.com/products/100-ohm-100e-1-smd-resistor-0805-pack-of-20-pieces | https://robu.in/?s=100R%200805%20resistor%201%25&post_type=product | https://quartzcomponents.com/search?q=100R%200805%20resistor%201%25&type=product | https://evelta.com/search.php?search_query=100R%200805%20resistor%201%25 | 0805; select 1% tolerance, >=0.125W. Do not round 732k feedback resistor to a different value. | 2026-11-10
R2 | 1 | 100R | 0805 | bottom | FIT | Matching listing found; confirm stock at checkout | https://quartzcomponents.com/products/100-ohm-100e-1-smd-resistor-0805-pack-of-20-pieces | https://robu.in/?s=100R%200805%20resistor%201%25&post_type=product | https://quartzcomponents.com/search?q=100R%200805%20resistor%201%25&type=product | https://evelta.com/search.php?search_query=100R%200805%20resistor%201%25 | 0805; select 1% tolerance, >=0.125W. Do not round 732k feedback resistor to a different value. | 2026-11-10
R3 | 1 | 100R | 0805 | bottom | FIT | Matching listing found; confirm stock at checkout | https://quartzcomponents.com/products/100-ohm-100e-1-smd-resistor-0805-pack-of-20-pieces | https://robu.in/?s=100R%200805%20resistor%201%25&post_type=product | https://quartzcomponents.com/search?q=100R%200805%20resistor%201%25&type=product | https://evelta.com/search.php?search_query=100R%200805%20resistor%201%25 | 0805; select 1% tolerance, >=0.125W. Do not round 732k feedback resistor to a different value. | 2026-11-10
R4 | 1 | 100R | 0805 | top | FIT | Matching listing found; confirm stock at checkout | https://quartzcomponents.com/products/100-ohm-100e-1-smd-resistor-0805-pack-of-20-pieces | https://robu.in/?s=100R%200805%20resistor%201%25&post_type=product | https://quartzcomponents.com/search?q=100R%200805%20resistor%201%25&type=product | https://evelta.com/search.php?search_query=100R%200805%20resistor%201%25 | 0805; select 1% tolerance, >=0.125W. Do not round 732k feedback resistor to a different value. | 2026-11-10
R5 | 1 | 100k | 0805 | bottom | FIT | Search links only; exact orderable SKU not confirmed |  | https://robu.in/?s=100k%200805%20resistor%201%25&post_type=product | https://quartzcomponents.com/search?q=100k%200805%20resistor%201%25&type=product | https://evelta.com/search.php?search_query=100k%200805%20resistor%201%25 | 0805; select 1% tolerance, >=0.125W. Do not round 732k feedback resistor to a different value. | 2026-11-10
R6 | 1 | 100k | 0805 | bottom | FIT | Search links only; exact orderable SKU not confirmed |  | https://robu.in/?s=100k%200805%20resistor%201%25&post_type=product | https://quartzcomponents.com/search?q=100k%200805%20resistor%201%25&type=product | https://evelta.com/search.php?search_query=100k%200805%20resistor%201%25 | 0805; select 1% tolerance, >=0.125W. Do not round 732k feedback resistor to a different value. | 2026-11-10
R7 | 1 | 100k | 0805 | bottom | FIT | Search links only; exact orderable SKU not confirmed |  | https://robu.in/?s=100k%200805%20resistor%201%25&post_type=product | https://quartzcomponents.com/search?q=100k%200805%20resistor%201%25&type=product | https://evelta.com/search.php?search_query=100k%200805%20resistor%201%25 | 0805; select 1% tolerance, >=0.125W. Do not round 732k feedback resistor to a different value. | 2026-11-10
R8 | 1 | 100k | 0805 | bottom | FIT | Search links only; exact orderable SKU not confirmed |  | https://robu.in/?s=100k%200805%20resistor%201%25&post_type=product | https://quartzcomponents.com/search?q=100k%200805%20resistor%201%25&type=product | https://evelta.com/search.php?search_query=100k%200805%20resistor%201%25 | 0805; select 1% tolerance, >=0.125W. Do not round 732k feedback resistor to a different value. | 2026-11-10
R9 | 1 | 100k 1% | 0805 | bottom | FIT | Search links only; exact orderable SKU not confirmed |  | https://robu.in/?s=100k%201%25%200805%20resistor%201%25&post_type=product | https://quartzcomponents.com/search?q=100k%201%25%200805%20resistor%201%25&type=product | https://evelta.com/search.php?search_query=100k%201%25%200805%20resistor%201%25 | 0805; select 1% tolerance, >=0.125W. Do not round 732k feedback resistor to a different value. | 2026-11-10
R10 | 1 | 47k 1% | 0805 | bottom | FIT | Search links only; exact orderable SKU not confirmed |  | https://robu.in/?s=47k%201%25%200805%20resistor%201%25&post_type=product | https://quartzcomponents.com/search?q=47k%201%25%200805%20resistor%201%25&type=product | https://evelta.com/search.php?search_query=47k%201%25%200805%20resistor%201%25 | 0805; select 1% tolerance, >=0.125W. Do not round 732k feedback resistor to a different value. | 2026-11-10
R11 | 1 | 1k | 0805 | top | FIT | Search links only; exact orderable SKU not confirmed |  | https://robu.in/?s=1k%200805%20resistor%201%25&post_type=product | https://quartzcomponents.com/search?q=1k%200805%20resistor%201%25&type=product | https://evelta.com/search.php?search_query=1k%200805%20resistor%201%25 | 0805; select 1% tolerance, >=0.125W. Do not round 732k feedback resistor to a different value. | 2026-11-10
R12 | 1 | 10k | 0805 | top | FIT | Search links only; exact orderable SKU not confirmed |  | https://robu.in/?s=10k%200805%20resistor%201%25&post_type=product | https://quartzcomponents.com/search?q=10k%200805%20resistor%201%25&type=product | https://evelta.com/search.php?search_query=10k%200805%20resistor%201%25 | 0805; select 1% tolerance, >=0.125W. Do not round 732k feedback resistor to a different value. | 2026-11-10
R13 | 1 | 4.7k | 0805 | top | FIT | Search links only; exact orderable SKU not confirmed |  | https://robu.in/?s=4.7k%200805%20resistor%201%25&post_type=product | https://quartzcomponents.com/search?q=4.7k%200805%20resistor%201%25&type=product | https://evelta.com/search.php?search_query=4.7k%200805%20resistor%201%25 | 0805; select 1% tolerance, >=0.125W. Do not round 732k feedback resistor to a different value. | 2026-11-10
R14 | 1 | 10k | 0805 | top | FIT | Search links only; exact orderable SKU not confirmed |  | https://robu.in/?s=10k%200805%20resistor%201%25&post_type=product | https://quartzcomponents.com/search?q=10k%200805%20resistor%201%25&type=product | https://evelta.com/search.php?search_query=10k%200805%20resistor%201%25 | 0805; select 1% tolerance, >=0.125W. Do not round 732k feedback resistor to a different value. | 2026-11-10
R15 | 1 | 75R 1% | 0805 | top | FIT | Search links only; exact orderable SKU not confirmed |  | https://robu.in/?s=75R%201%25%200805%20resistor%201%25&post_type=product | https://quartzcomponents.com/search?q=75R%201%25%200805%20resistor%201%25&type=product | https://evelta.com/search.php?search_query=75R%201%25%200805%20resistor%201%25 | 0805; select 1% tolerance, >=0.125W. Do not round 732k feedback resistor to a different value. | 2026-11-10
R16 | 1 | 75R 1% | 0805 | top | FIT | Search links only; exact orderable SKU not confirmed |  | https://robu.in/?s=75R%201%25%200805%20resistor%201%25&post_type=product | https://quartzcomponents.com/search?q=75R%201%25%200805%20resistor%201%25&type=product | https://evelta.com/search.php?search_query=75R%201%25%200805%20resistor%201%25 | 0805; select 1% tolerance, >=0.125W. Do not round 732k feedback resistor to a different value. | 2026-11-10
R17 | 1 | 732k 1% | 0805 | bottom | FIT | Search links only; exact orderable SKU not confirmed |  | https://robu.in/?s=732k%201%25%200805%20resistor%201%25&post_type=product | https://quartzcomponents.com/search?q=732k%201%25%200805%20resistor%201%25&type=product | https://evelta.com/search.php?search_query=732k%201%25%200805%20resistor%201%25 | 0805; select 1% tolerance, >=0.125W. Do not round 732k feedback resistor to a different value. | 2026-11-10
R18 | 1 | 100k 1% | 0805 | bottom | FIT | Search links only; exact orderable SKU not confirmed |  | https://robu.in/?s=100k%201%25%200805%20resistor%201%25&post_type=product | https://quartzcomponents.com/search?q=100k%201%25%200805%20resistor%201%25&type=product | https://evelta.com/search.php?search_query=100k%201%25%200805%20resistor%201%25 | 0805; select 1% tolerance, >=0.125W. Do not round 732k feedback resistor to a different value. | 2026-11-10
R19 | 1 | 470R | 0805 | top | FIT | Search links only; exact orderable SKU not confirmed |  | https://robu.in/?s=470R%200805%20resistor%201%25&post_type=product | https://quartzcomponents.com/search?q=470R%200805%20resistor%201%25&type=product | https://evelta.com/search.php?search_query=470R%200805%20resistor%201%25 | 0805; select 1% tolerance, >=0.125W. Do not round 732k feedback resistor to a different value. | 2026-11-10
R20 | 1 | 100k | 0805 | top | FIT | Search links only; exact orderable SKU not confirmed |  | https://robu.in/?s=100k%200805%20resistor%201%25&post_type=product | https://quartzcomponents.com/search?q=100k%200805%20resistor%201%25&type=product | https://evelta.com/search.php?search_query=100k%200805%20resistor%201%25 | 0805; select 1% tolerance, >=0.125W. Do not round 732k feedback resistor to a different value. | 2026-11-10
R21 | 1 | 4.7k 1% | 0805 | top | FIT | Search links only; exact orderable SKU not confirmed |  | https://robu.in/?s=4.7k%201%25%200805%20resistor%201%25&post_type=product | https://quartzcomponents.com/search?q=4.7k%201%25%200805%20resistor%201%25&type=product | https://evelta.com/search.php?search_query=4.7k%201%25%200805%20resistor%201%25 | 0805; select 1% tolerance, >=0.125W. Do not round 732k feedback resistor to a different value. | 2026-11-10
U1 | 1 | XIAO ESP32-S3 direct SMD | XIAO_ESP32S3_Direct_SMD_UART | top | FIT | Matching listing found; confirm stock at checkout | https://robu.in/product/seeed-studio-xiao-esp32s3-2-4ghz-wifi-ble-5-0/ | https://robu.in/?s=XIAO%20ESP32-S3%20direct%20SMD%20XIAO_ESP32S3_Direct_SMD_UART&post_type=product | https://quartzcomponents.com/search?type=product | https://evelta.com/search.php | Match value, package and rating before ordering. Stock and prices are not guaranteed. | 2026-11-10
U2 | 1 | AT7456E | HTSSOP-28-1EP_4.4x9.7mm_P0.65mm_EP2.75x6.2mm_Compact | bottom | FIT | Prior record says owned; verify actual bare IC |  | https://robu.in/?s=AT7456E%20HTSSOP-28-1EP_4.4x9.7mm_P0.65mm_EP2.75x6.2mm_Compact&post_type=product | https://quartzcomponents.com/search?type=product | https://evelta.com/search.php | AT7456E HTSSOP-28 + exposed GND pad. A complete OSD module cannot mount on this footprint. | 2026-11-10
U3 | 1 | MPU-6050 | RevK_Assembly_U3 | bottom | FIT | User reports bare IC already owned | https://quartzcomponents.com/products/mpu-6050-3-axis-gyro-accelerometer-ic-tdk-invensense-qfn-24-smd-package | https://robu.in/product/mpu-6050-qfn-24-3-axis-gyro-accelerometer-ic/ | https://zbotic.in/product/mpu-6050-qfn-24-3-axis-gyro-accelerometer-ic/ | https://robu.in/?s=MPU-6050%20RevK_Assembly_U3&post_type=product | https://quartzcomponents.com/search?q=MPU-6050%20RevK_Assembly_U3&type=product | https://evelta.com/search.php?search_query=MPU-6050%20RevK_Assembly_U3 | Use MPU-6050 bare 4x4mm QFN-24, not GY-521 module. Center die must remain unsoldered. | 2026-11-10
U4 | 1 | TPS61023DRLR | SOT-563_Compact_Assembly | bottom | FIT | Matching listing found; confirm stock at checkout | https://robu.in/product/tps61023drlr-texas-instruments-boost-type-adjustable-2-2v5-5v-3a-500mv5-5v-sot-563-dc-dc-converters-rohs/ | https://robu.in/?s=TPS61023DRLR%20SOT-563_Compact_Assembly&post_type=product | https://quartzcomponents.com/search?q=TPS61023DRLR%20SOT-563_Compact_Assembly&type=product | https://evelta.com/search.php?search_query=TPS61023DRLR%20SOT-563_Compact_Assembly | Match value, package and rating before ordering. Stock and prices are not guaranteed. | 2026-11-10
U5 | 1 | SN74LVC1G17DBVR | Receiver_Buffer_SOT23_5 | bottom | FIT | Search links only; exact orderable SKU not confirmed |  | https://robu.in/?s=SN74LVC1G17DBVR%20Receiver_Buffer_SOT23_5&post_type=product | https://quartzcomponents.com/search?q=SN74LVC1G17DBVR%20Receiver_Buffer_SOT23_5&type=product | https://evelta.com/search.php?search_query=SN74LVC1G17DBVR%20Receiver_Buffer_SOT23_5 | Match value, package and rating before ordering. Stock and prices are not guaranteed. | 2026-11-10
Y1 | 1 | YSX321SL 27MHz 12pF | RevK_Assembly_Y1 | bottom | FIT | Listing specifies 27MHz/12pF; seller confirmation required | https://evelta.com/ysx321sl-27mhz-12pf-10ppm-4pins-smd-smt-metal-surface-quartz-crystal/ | https://robu.in/?s=YSX321SL%2027MHz%2012pF%20RevK_Assembly_Y1&post_type=product | https://quartzcomponents.com/search?q=YSX321SL%2027MHz%2012pF%20RevK_Assembly_Y1&type=product | https://evelta.com/search.php?search_query=YSX321SL%2027MHz%2012pF%20RevK_Assembly_Y1 | YSX321SL 3225 passive crystal, 27MHz, CL12pF, pads2/4GND. Evelta MPN XL2OI-111-27M differs from displayed family: confirm passive crystal and land pattern, not active oscillator. | 2026-11-10
