Athul24milu/ESPFC-WHOOP-/04_KiCad_Project/ESP_FPV_ATHUL_IOGROUPED.kicad_pcb

## KiCad design 04_KiCad_Project/ESP_FPV_ATHUL_IOGROUPED.kicad_pcb (2026-11-10)

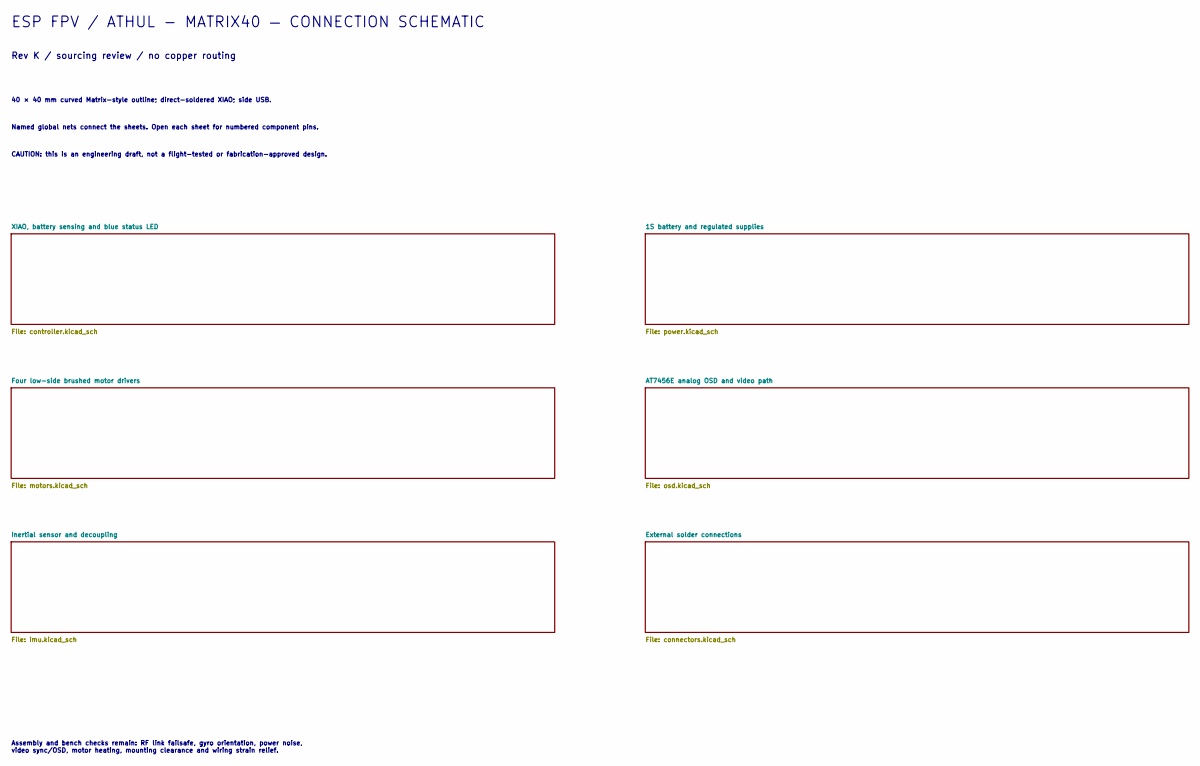
[picture p19: schematic ESP_FPV_ATHUL_IOGROUPED.kicad_sch, ESP FPV / ATHUL - 1S FC]

Notes on the sheet:
ESP FPV / ATHUL - MATRIX40 — CONNECTION SCHEMATIC
Rev K / sourcing review / no copper routing
40 × 40 mm curved Matrix-style outline; direct-soldered XIAO; side USB.
Named global nets connect the sheets. Open each sheet for numbered component pins.
CAUTION: this is an engineering draft, not a flight-tested or fabrication-approved design.
Assembly and bench checks remain: RF link failsafe, gyro orientation, power noise, video sync/OSD, motor heating, mounting clearance and wiring strain relief.

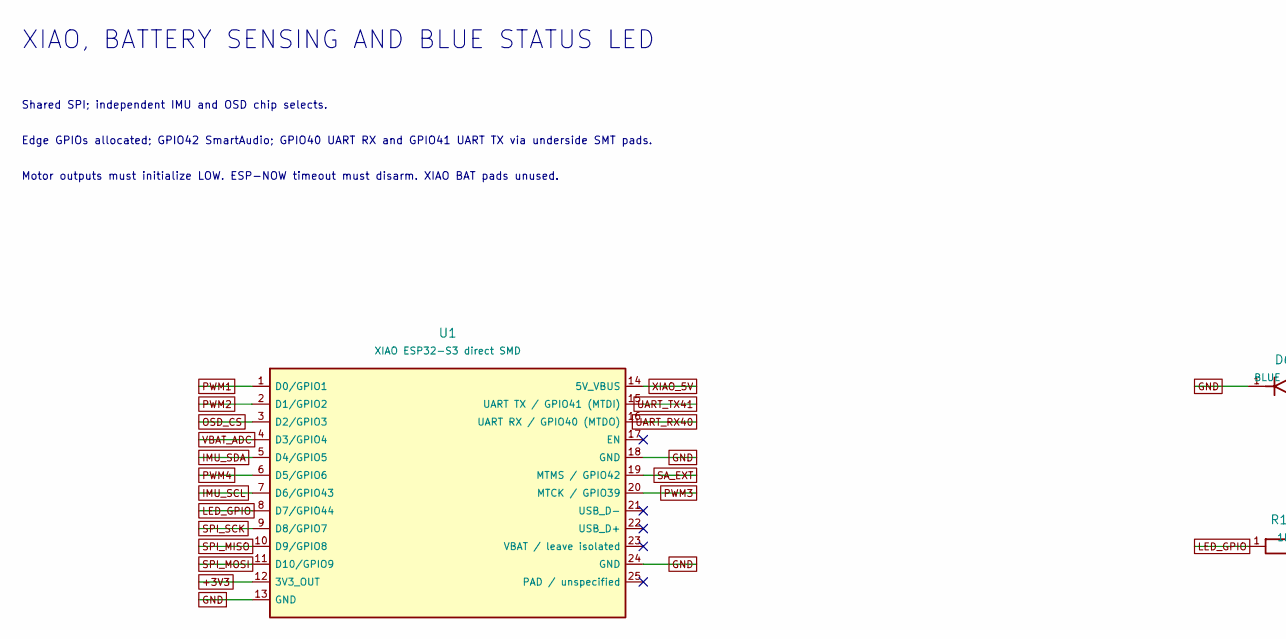
[picture p20: schematic controller.kicad_sch, part in row 1, column 1]

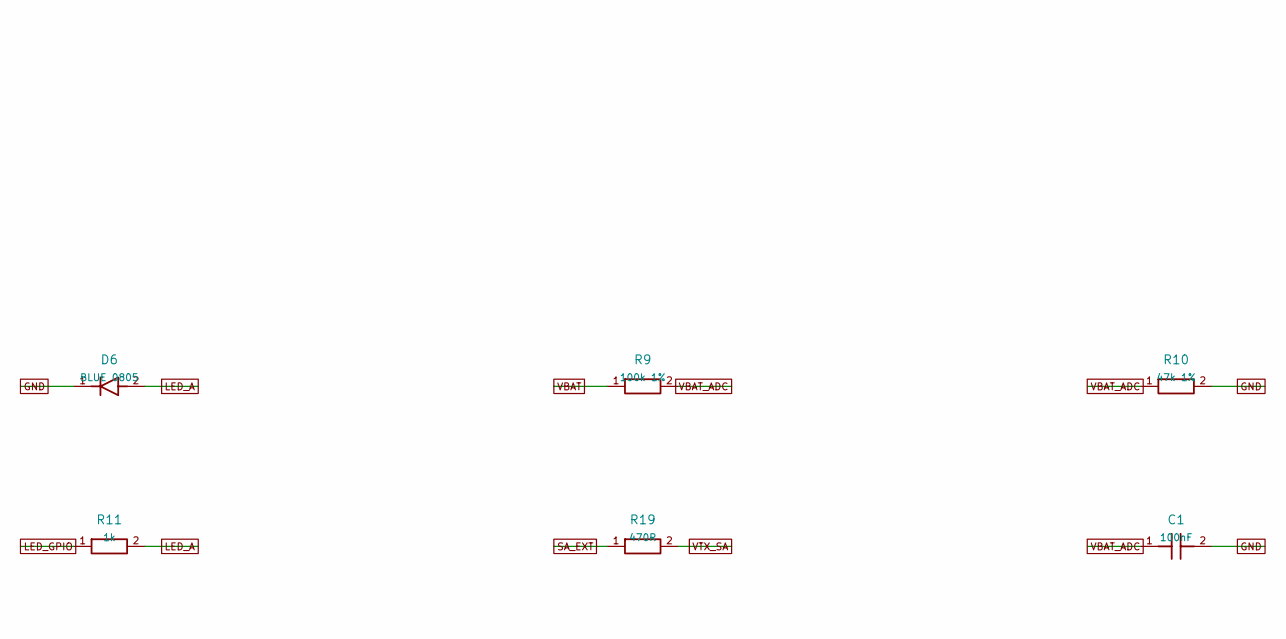
[picture p21: schematic controller.kicad_sch, part in row 1, column 2]

Parts:
C1: 100nF; C_0805_2012Metric_Compact
D6: BLUE 0805; LED_0805_2012Metric_Compact_Assembly
R9: 100k 1%; R_0805_2012Metric_Compact
R10: 47k 1%; R_0805_2012Metric_Compact
R11: 1k; R_0805_2012Metric_Compact
R19: 470R; R_0805_2012Metric_Compact
U1: XIAO ESP32-S3 direct SMD; XIAO_ESP32S3_Direct_SMD_UART

Connections:
+3V3: U1.12 (3V3_OUT); also elsewhere on the board
GND: C1.2, D6.1 (K), R10.2, U1.13 (GND), U1.18 (GND), U1.24 (GND); also elsewhere on the board
IMU_SCL: U1.7 (D6/GPIO43); also elsewhere on the board
IMU_SDA: U1.5 (D4/GPIO5); also elsewhere on the board
LED_A: D6.2 (A), R11.2
LED_GPIO: R11.1, U1.8 (D7/GPIO44)
OSD_CS: U1.3 (D2/GPIO3); also elsewhere on the board
PWM1: U1.1 (D0/GPIO1); also elsewhere on the board
PWM2: U1.2 (D1/GPIO2); also elsewhere on the board
PWM3: U1.20 (MTCK / GPIO39); also elsewhere on the board
PWM4: U1.6 (D5/GPIO6); also elsewhere on the board
SA_EXT: R19.1, U1.19 (MTMS / GPIO42)
SPI_MISO: U1.10 (D9/GPIO8); also elsewhere on the board
SPI_MOSI: U1.11 (D10/GPIO9); also elsewhere on the board
SPI_SCK: U1.9 (D8/GPIO7); also elsewhere on the board
UART_RX40: U1.16 (UART RX / GPIO40 (MTDO)); also elsewhere on the board
UART_TX41: U1.15 (UART TX / GPIO41 (MTDI)); also elsewhere on the board
VBAT: R9.1; also elsewhere on the board
VBAT_ADC: C1.1, R9.2, R10.1, U1.4 (D3/GPIO4)
VTX_SA: R19.2; also elsewhere on the board
XIAO_5V: U1.14 (5V_VBUS); also elsewhere on the board

Notes on the sheet:
XIAO, BATTERY SENSING AND BLUE STATUS LED
Shared SPI; independent IMU and OSD chip selects.
Edge GPIOs allocated; GPIO42 SmartAudio; GPIO40 UART RX and GPIO41 UART TX via underside SMT pads.
Motor outputs must initialize LOW. ESP-NOW timeout must disarm. XIAO BAT pads unused.

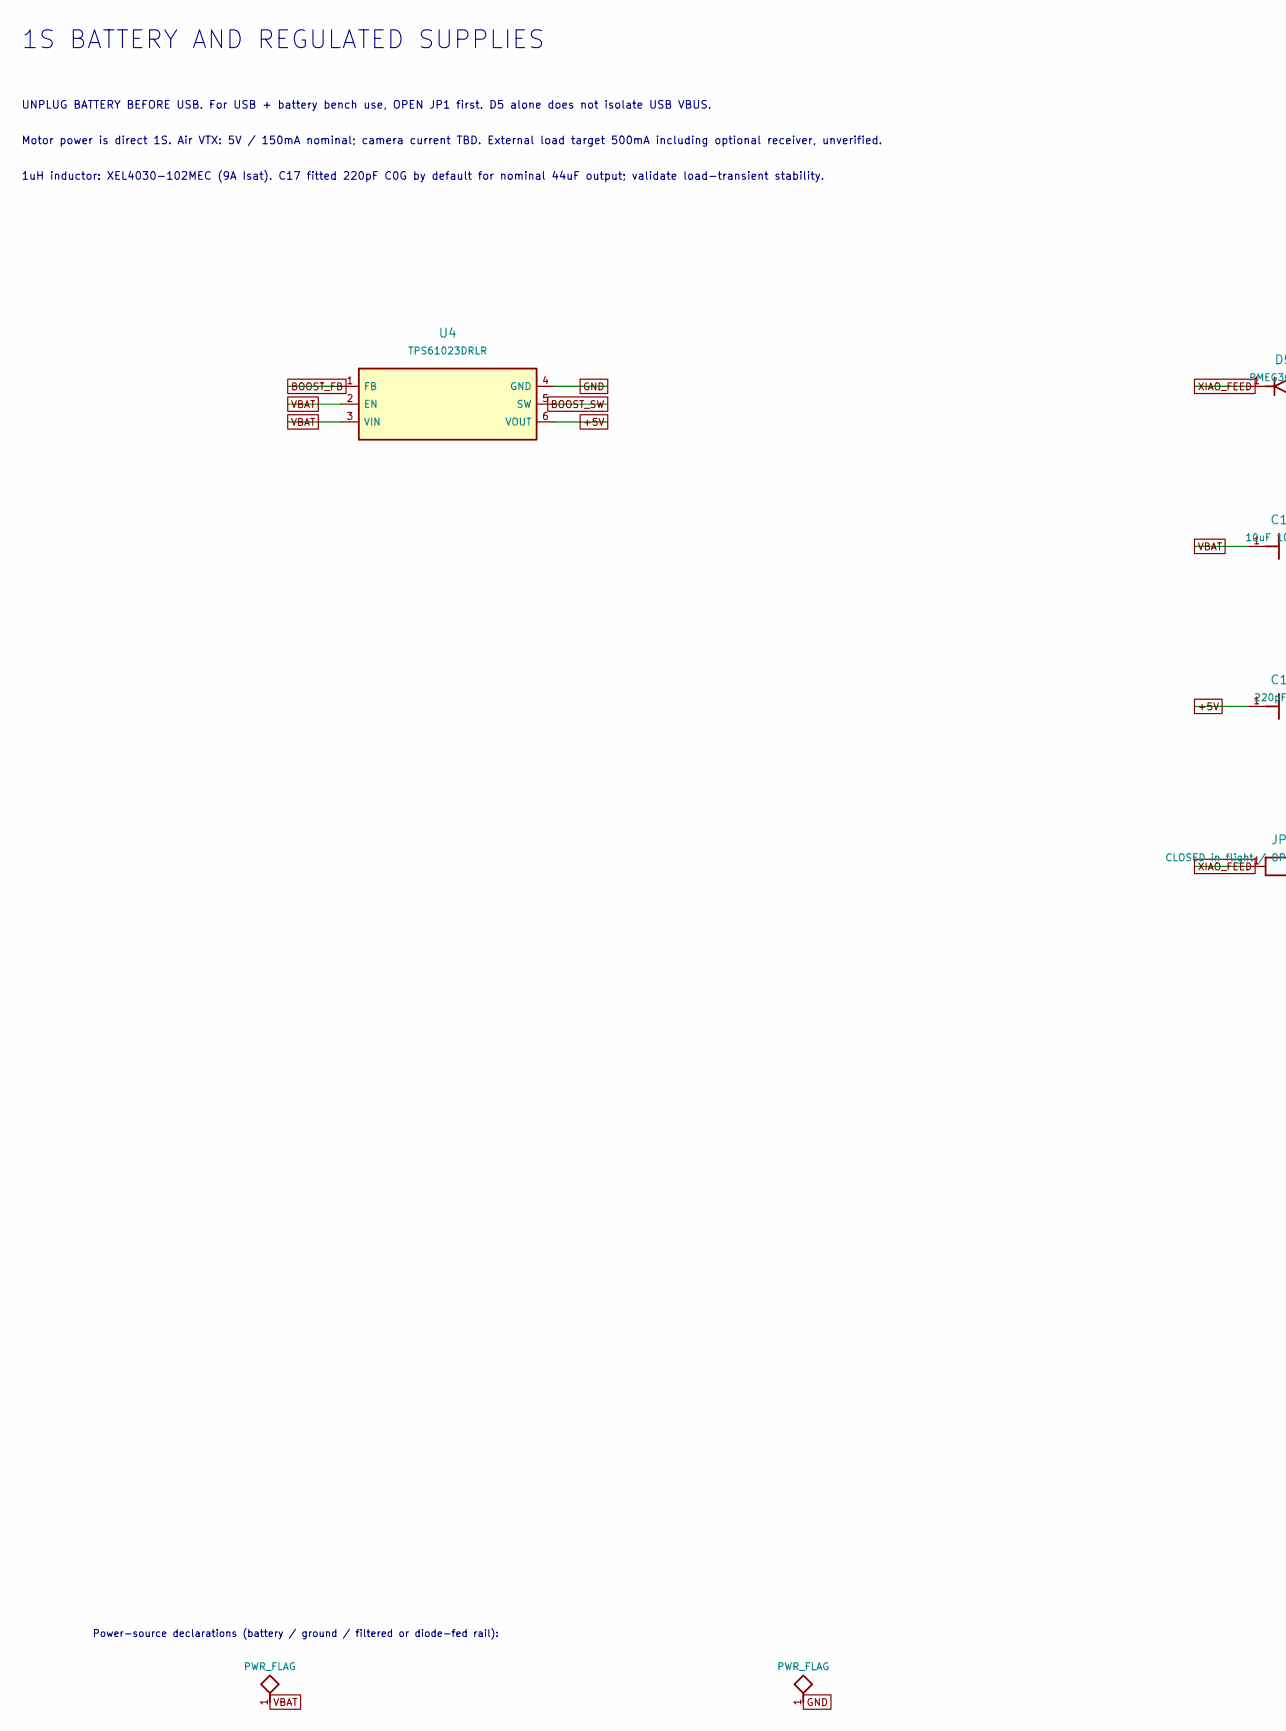
[picture p22: schematic power.kicad_sch, 1S power, part in row 1, column 1]

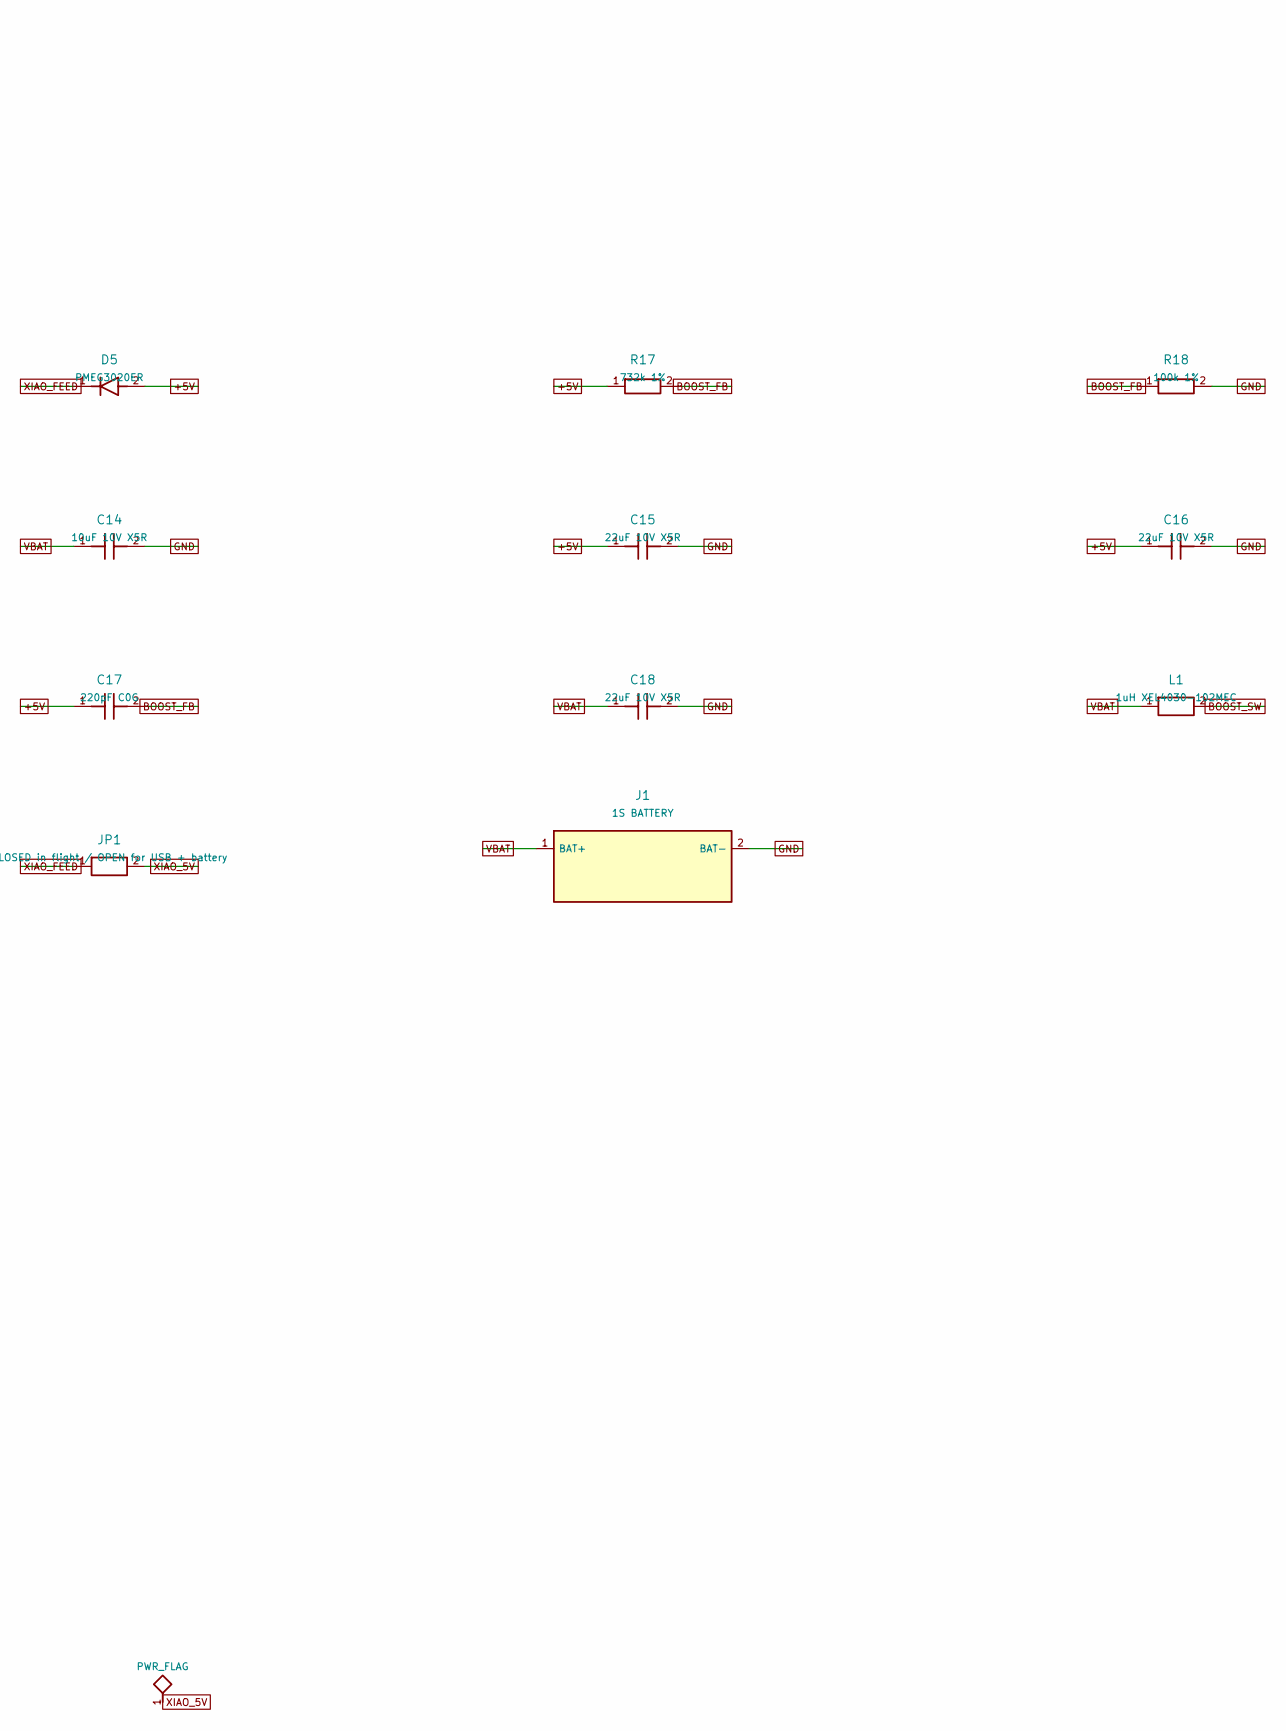
[picture p23: schematic power.kicad_sch, 1S power, part in row 1, column 2]

Parts:
C14: 10uF 10V X5R; C_0805_2012Metric_Compact
C15, C16, C18: 22uF 10V X5R; C_0805_2012Metric_Compact
C17: 220pF C0G; C_0805_2012Metric_Compact
D5: PMEG3020ER; RevK_Assembly_D5
J1: 1S BATTERY; Battery_Pads_2p6
JP1: CLOSED in flight / OPEN for USB + battery; SolderJumper-2_P1.3mm_Bridged_Pad1.0x1.5mm_Compact
L1: 1uH XEL4030-102MEC; L_Coilcraft_XxL4030_Compact
R17: 732k 1%; R_0805_2012Metric_Compact
R18: 100k 1%; R_0805_2012Metric_Compact
U4: TPS61023DRLR; SOT-563_Compact_Assembly

Connections:
+5V: C15.1, C16.1, C17.1, D5.2 (A), R17.1, U4.6 (VOUT); also elsewhere on the board
BOOST_FB: C17.2, R17.2, R18.1, U4.1 (FB)
BOOST_SW: L1.2, U4.5 (SW)
GND: C14.2, C15.2, C16.2, C18.2, J1.2 (BAT-), R18.2, U4.4 (GND); also elsewhere on the board
VBAT: C14.1, C18.1, J1.1 (BAT+), L1.1, U4.2 (EN), U4.3 (VIN); also elsewhere on the board
XIAO_5V: JP1.2; also elsewhere on the board
XIAO_FEED: D5.1 (K), JP1.1

Notes on the sheet:
1S BATTERY AND REGULATED SUPPLIES
UNPLUG BATTERY BEFORE USB. For USB + battery bench use, OPEN JP1 first. D5 alone does not isolate USB VBUS.
Motor power is direct 1S. Air VTX: 5V / 150mA nominal; camera current TBD. External load target 500mA including optional receiver, unverified.
1uH inductor: XEL4030-102MEC (9A Isat). C17 fitted 220pF C0G by default for nominal 44uF output; validate load-transient stability.
Power-source declarations (battery / ground / filtered or diode-fed rail):

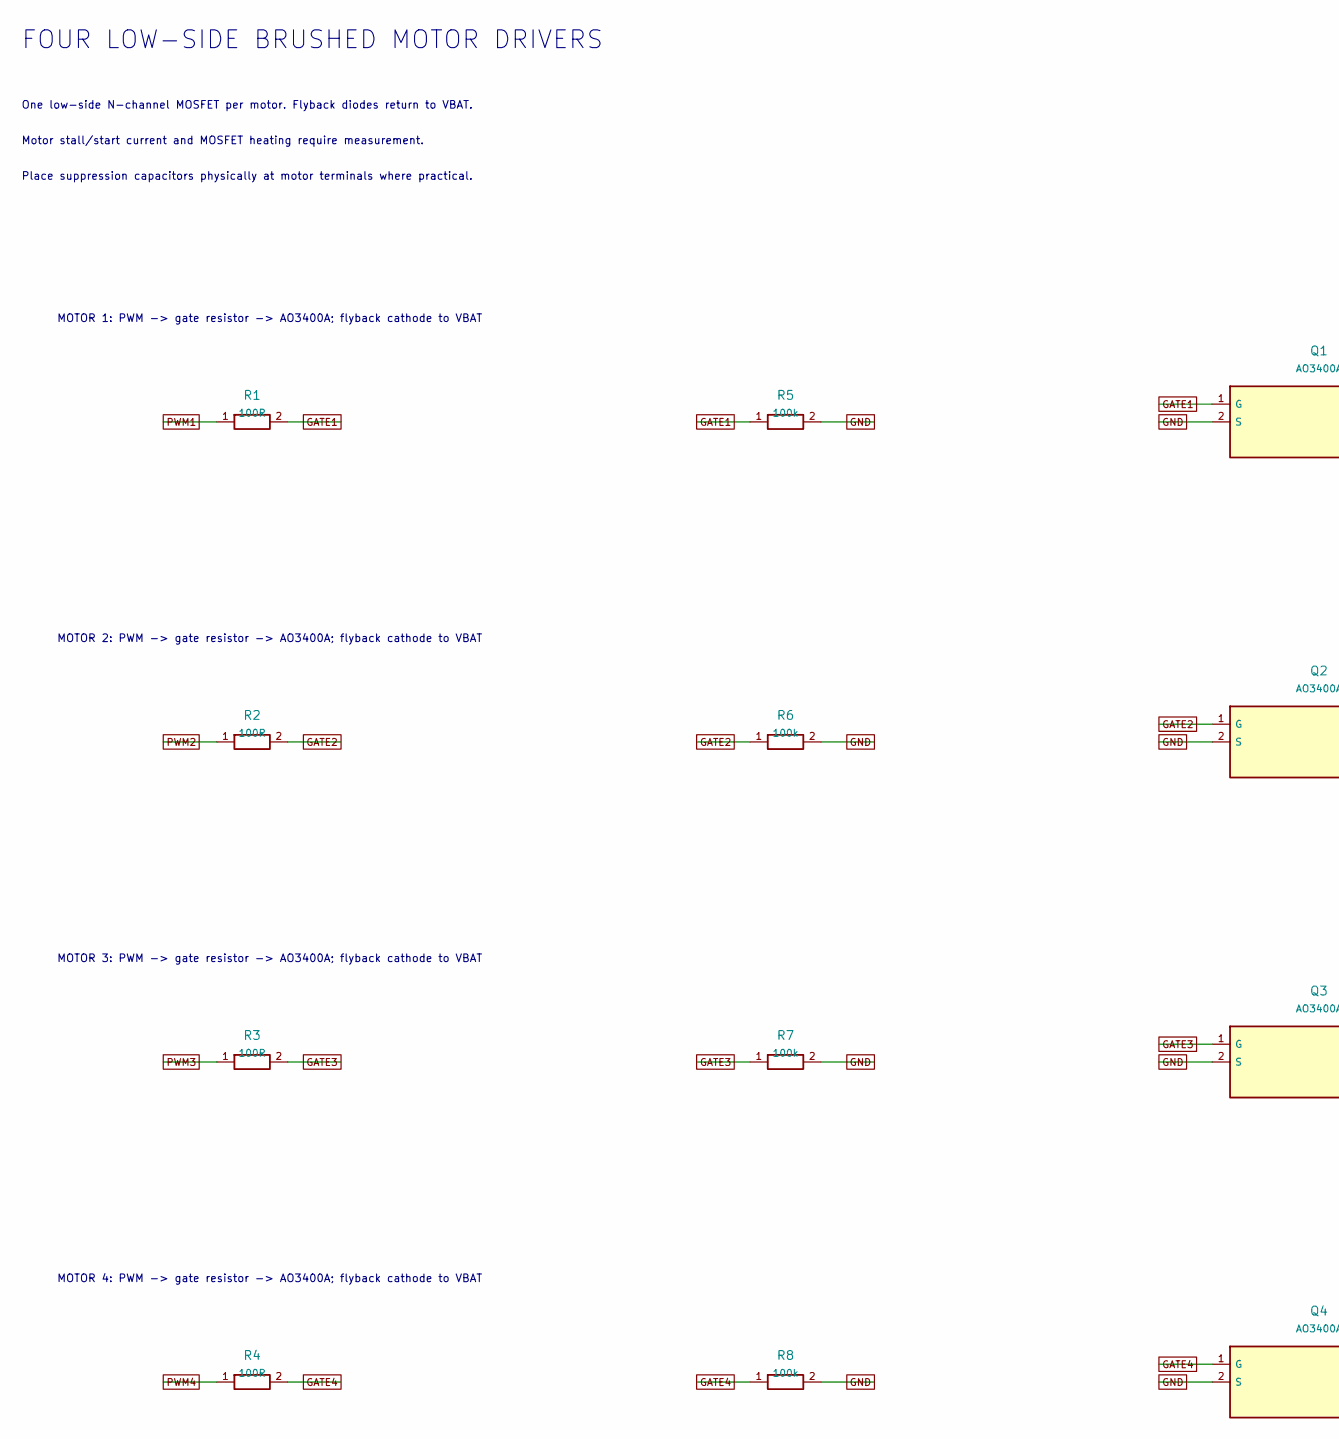
[picture p24: schematic motors.kicad_sch, Motor drivers, part in row 1, column 1]

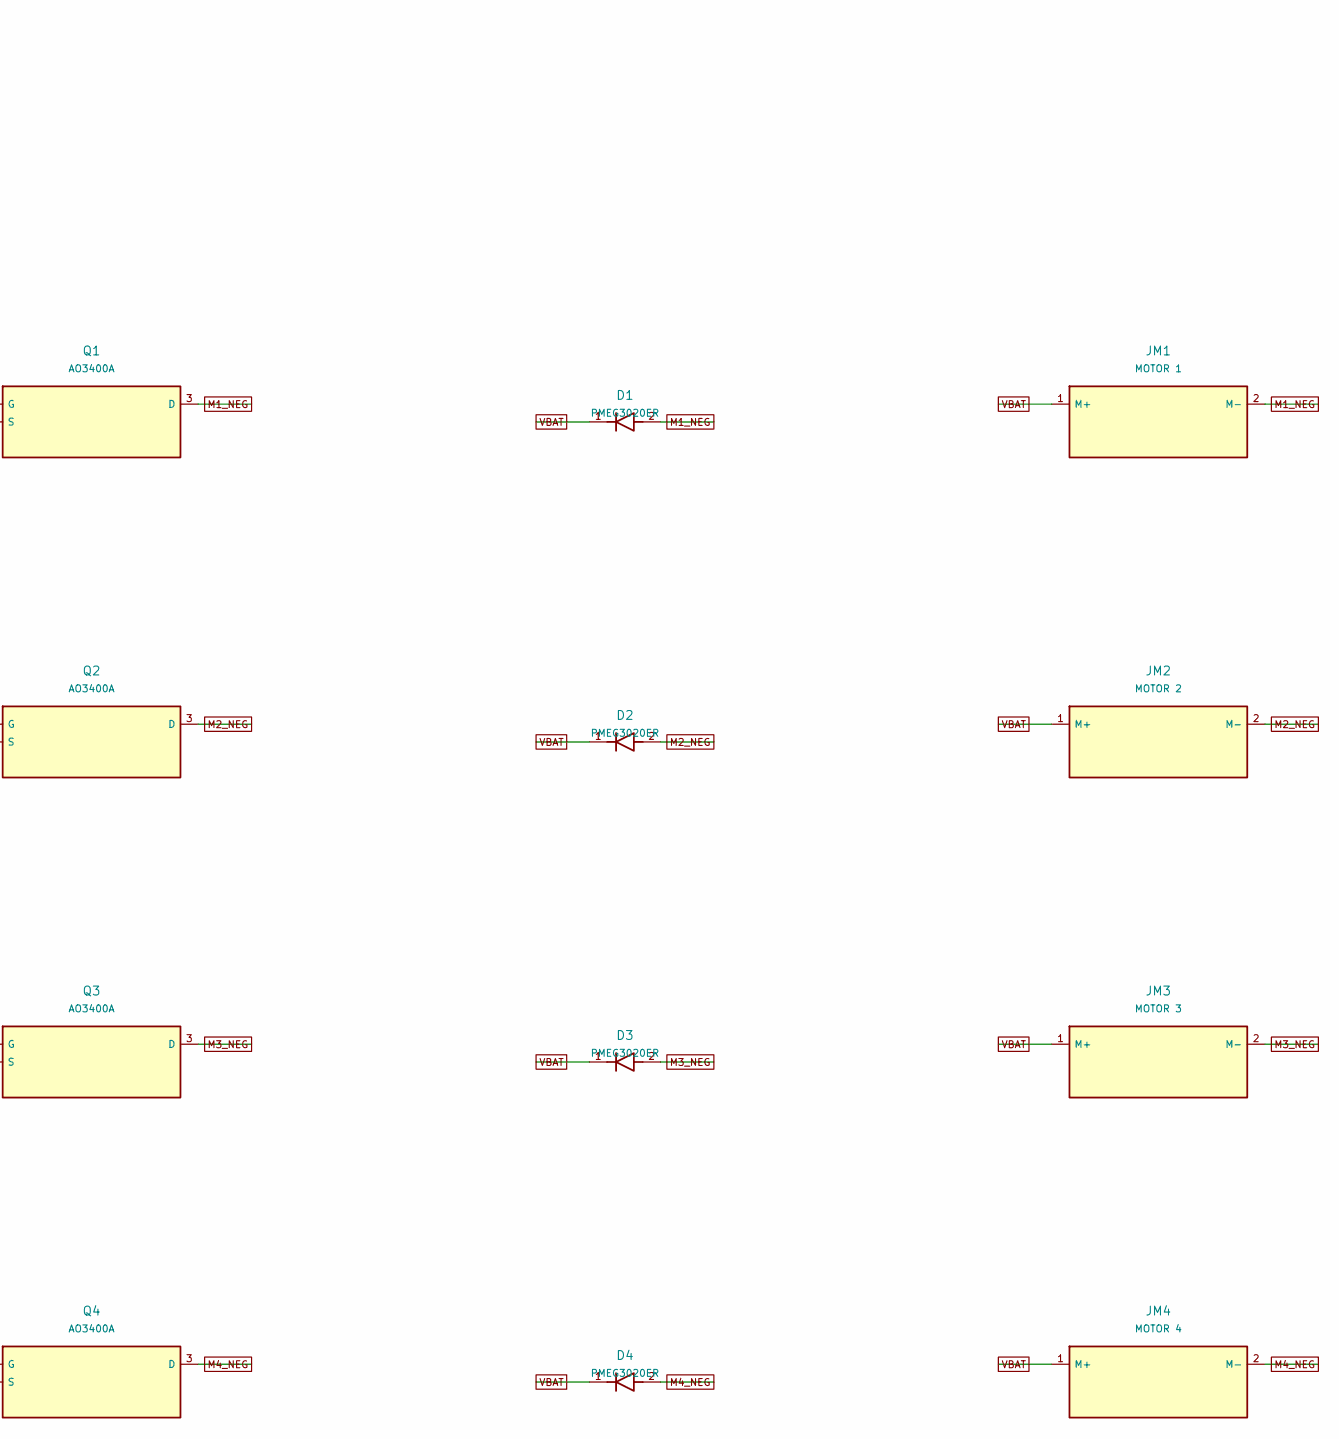
[picture p25: schematic motors.kicad_sch, Motor drivers, part in row 1, column 2]

Parts:
D1: PMEG3020ER; Nexperia_CFP3_SOD-123W_Compact
D2: PMEG3020ER; RevK_Assembly_D2
D3: PMEG3020ER; Nexperia_CFP3_SOD-123W_Compact_Assembly
D4: PMEG3020ER; Nexperia_CFP3_SOD-123W_CurvedEdge
JM1: MOTOR 1; RevK_Assembly_JM1
JM2: MOTOR 2; RevK_Assembly_JM2
JM3: MOTOR 3; RevK_Assembly_JM3
JM4: MOTOR 4; RevK_Assembly_JM4
Q1: AO3400A; RevK_Assembly_Q1
Q2: AO3400A; SOT-23_Compact
Q3: AO3400A; SOT-23_Compact_Assembly
Q4: AO3400A; RevK_Assembly_Q4
R1, R2, R3, R4: 100R; R_0805_2012Metric_Compact
R5, R7: 100k; R_0805_2012Metric_Compact
R6, R8: 100k; R_0805_2012Metric_Compact_Assembly

Connections:
GATE1: Q1.1 (G), R1.2, R5.1
GATE2: Q2.1 (G), R2.2, R6.1
GATE3: Q3.1 (G), R3.2, R7.1
GATE4: Q4.1 (G), R4.2, R8.1
GND: Q1.2 (S), Q2.2 (S), Q3.2 (S), Q4.2 (S), R5.2, R6.2, R7.2, R8.2; also elsewhere on the board
M1_NEG: D1.2 (A), JM1.2 (M-), Q1.3 (D)
M2_NEG: D2.2 (A), JM2.2 (M-), Q2.3 (D)
M3_NEG: D3.2 (A), JM3.2 (M-), Q3.3 (D)
M4_NEG: D4.2 (A), JM4.2 (M-), Q4.3 (D)
PWM1: R1.1; also elsewhere on the board
PWM2: R2.1; also elsewhere on the board
PWM3: R3.1; also elsewhere on the board
PWM4: R4.1; also elsewhere on the board
VBAT: D1.1 (K), D2.1 (K), D3.1 (K), D4.1 (K), JM1.1 (M+), JM2.1 (M+), JM3.1 (M+), JM4.1 (M+); also elsewhere on the board

Notes on the sheet:
FOUR LOW-SIDE BRUSHED MOTOR DRIVERS
One low-side N-channel MOSFET per motor. Flyback diodes return to VBAT.
Motor stall/start current and MOSFET heating require measurement.
Place suppression capacitors physically at motor terminals where practical.
MOTOR 1: PWM -> gate resistor -> AO3400A; flyback cathode to VBAT
MOTOR 2: PWM -> gate resistor -> AO3400A; flyback cathode to VBAT
MOTOR 3: PWM -> gate resistor -> AO3400A; flyback cathode to VBAT
MOTOR 4: PWM -> gate resistor -> AO3400A; flyback cathode to VBAT

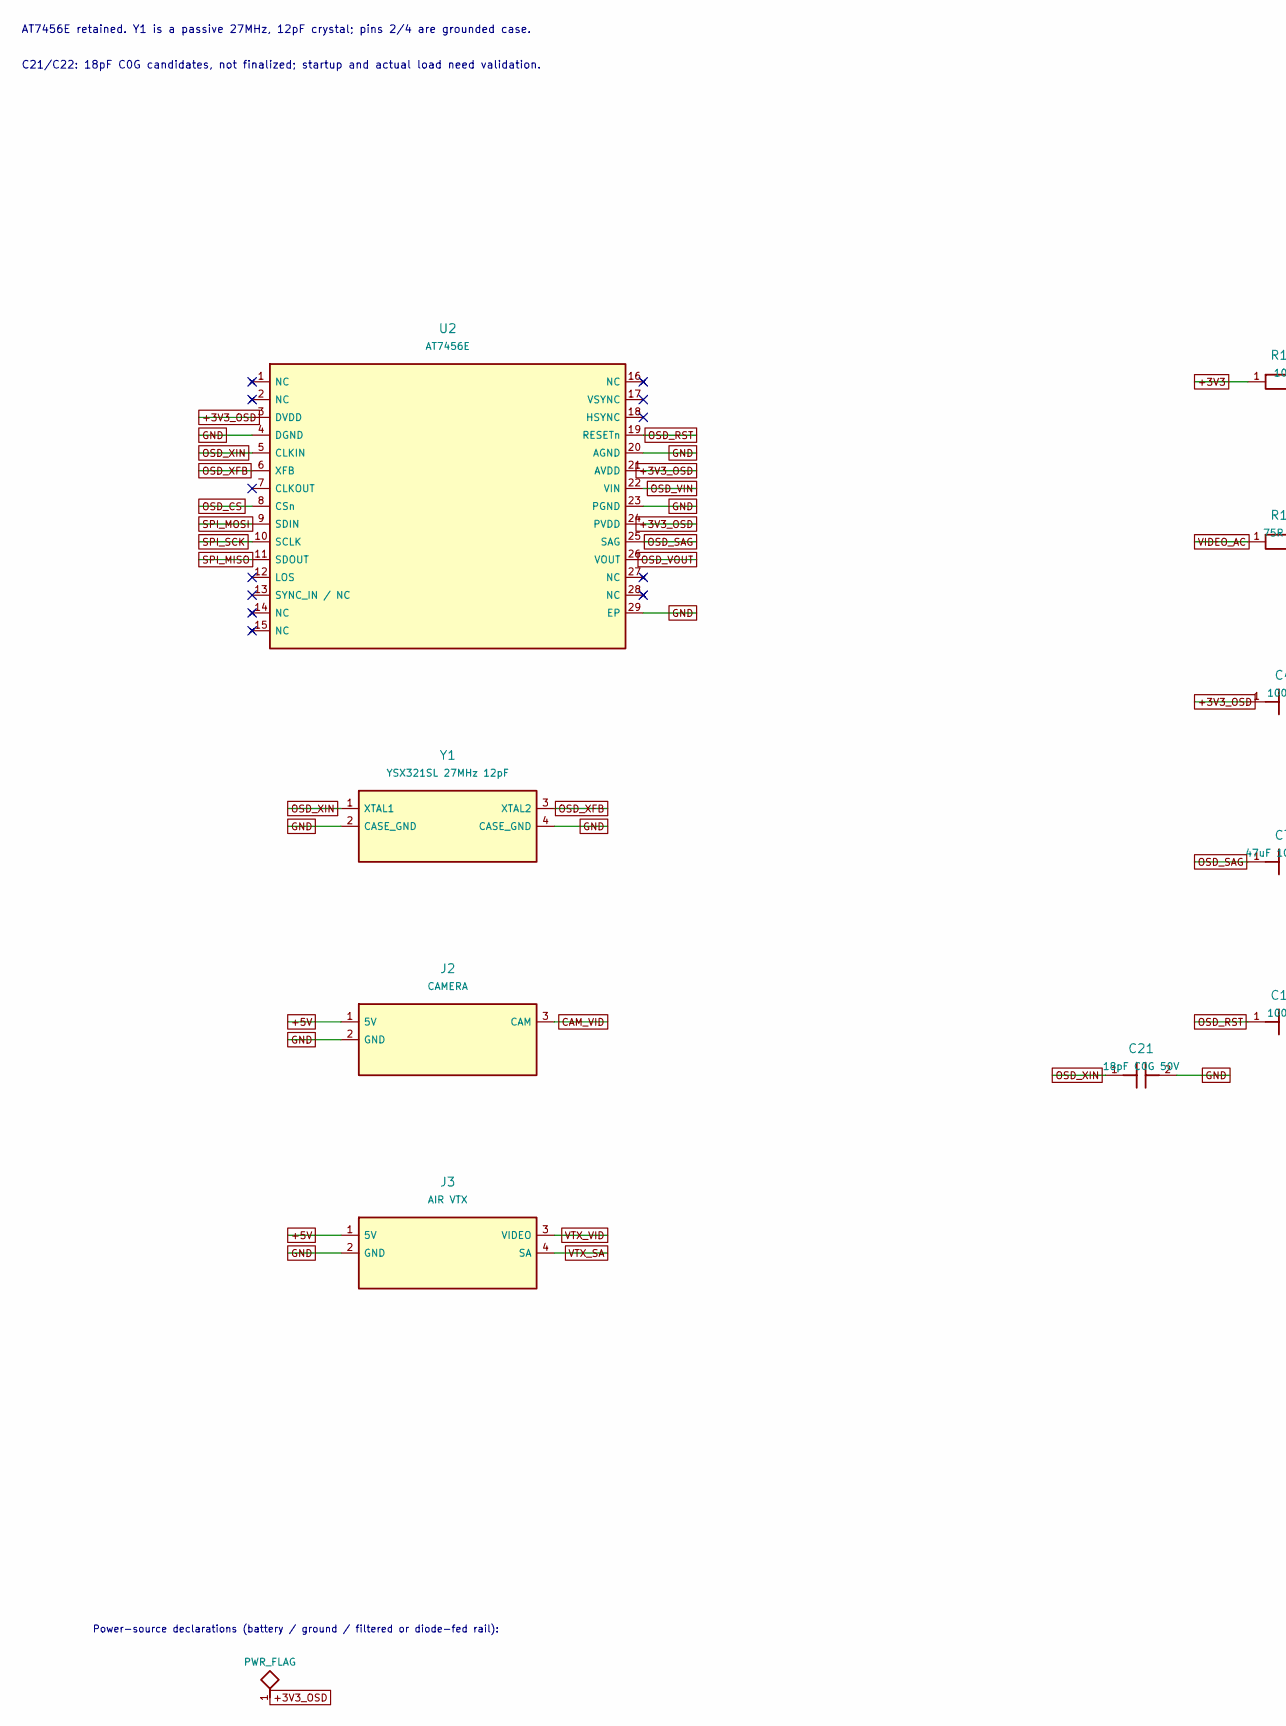
[picture p26: schematic osd.kicad_sch, Analog OSD, part in row 1, column 1]

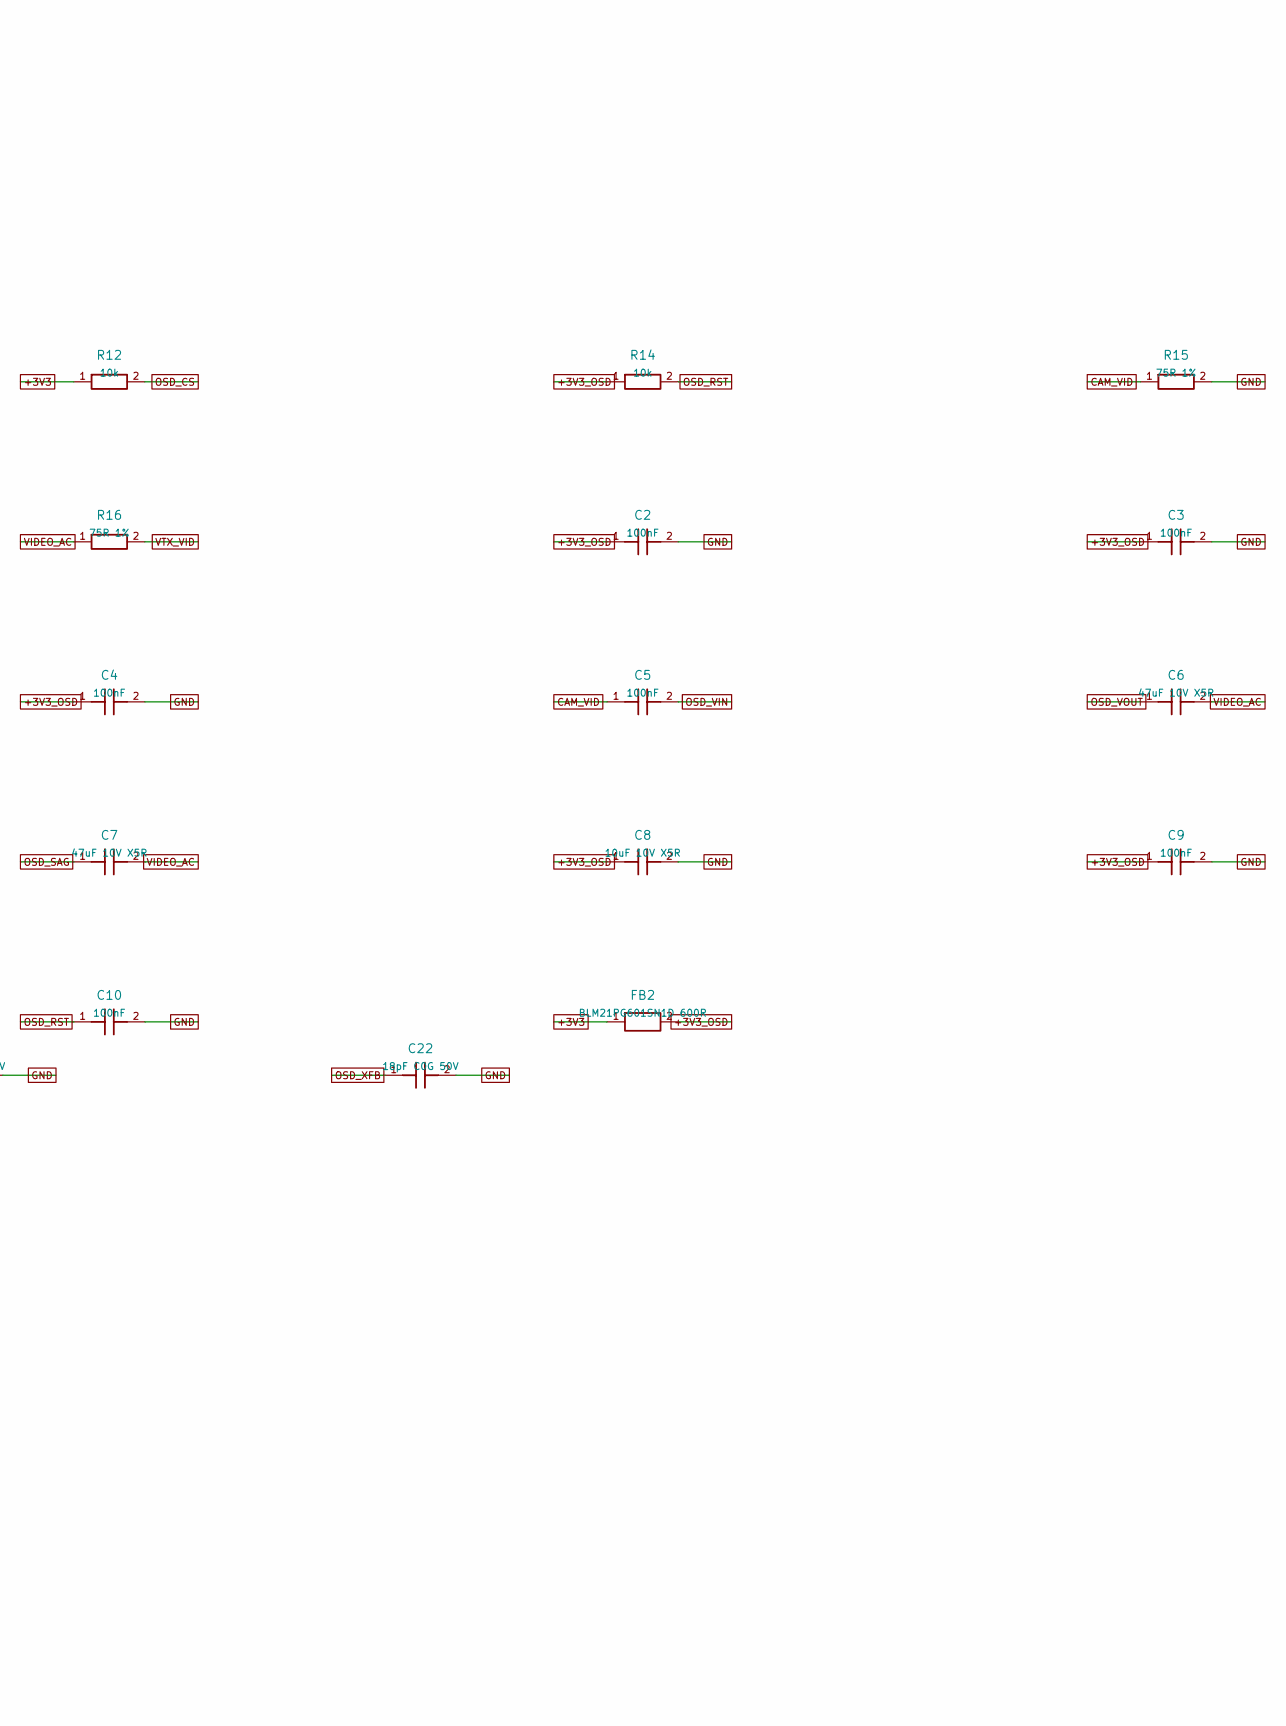
[picture p27: schematic osd.kicad_sch, Analog OSD, part in row 1, column 2]

Parts:
C2, C3, C4, C5, C9, C10: 100nF; C_0805_2012Metric_Compact
C6, C7: 47uF 10V X5R; C_1206_3216Metric_Compact
C8: 10uF 10V X5R; C_0805_2012Metric_Compact
C21, C22: 18pF C0G 50V; C_0805_2012Metric_Compact
FB2: BLM21PG601SN1D 600R; L_0805_2012Metric_Compact
J2: CAMERA; Camera_Pads_1p65
J3: AIR VTX; VTX_Pads_1p65
R12, R14: 10k; R_0805_2012Metric_Compact
R15, R16: 75R 1%; R_0805_2012Metric_Compact
U2: AT7456E; HTSSOP-28-1EP_4.4x9.7mm_P0.65mm_EP2.75x6.2mm_Compact
Y1: YSX321SL 27MHz 12pF; RevK_Assembly_Y1

Connections:
+3V3: FB2.1, R12.1; also elsewhere on the board
+3V3_OSD: C2.1, C3.1, C4.1, C8.1, C9.1, FB2.2, R14.1, U2.3 (DVDD), U2.21 (AVDD), U2.24 (PVDD)
+5V: J2.1 (5V), J3.1 (5V); also elsewhere on the board
CAM_VID: C5.1, J2.3 (CAM), R15.1
GND: C2.2, C3.2, C4.2, C8.2, C9.2, C10.2, C21.2, C22.2, J2.2 (GND), J3.2 (GND), R15.2, U2.4 (DGND), U2.20 (AGND), U2.23 (PGND), U2.29 (EP), Y1.2 (CASE_GND), Y1.4 (CASE_GND); also elsewhere on the board
OSD_CS: R12.2, U2.8 (CSn); also elsewhere on the board
OSD_RST: C10.1, R14.2, U2.19 (RESETn)
OSD_SAG: C7.1, U2.25 (SAG)
OSD_VIN: C5.2, U2.22 (VIN)
OSD_VOUT: C6.1, U2.26 (VOUT)
OSD_XFB: C22.1, U2.6 (XFB), Y1.3 (XTAL2)
OSD_XIN: C21.1, U2.5 (CLKIN), Y1.1 (XTAL1)
SPI_MISO: U2.11 (SDOUT); also elsewhere on the board
SPI_MOSI: U2.9 (SDIN); also elsewhere on the board
SPI_SCK: U2.10 (SCLK); also elsewhere on the board
VIDEO_AC: C6.2, C7.2, R16.1
VTX_SA: J3.4 (SA); also elsewhere on the board
VTX_VID: J3.3 (VIDEO), R16.2

Notes on the sheet:
Power-source declarations (battery / ground / filtered or diode-fed rail):
AT7456E retained. Y1 is a passive 27MHz, 12pF crystal; pins 2/4 are grounded case.
C21/C22: 18pF C0G candidates, not finalized; startup and actual load need validation.
