Athul24milu/ESPFC-WHOOP-/04_KiCad_Project/ESP_FPV_ATHUL_IOGROUPED.kicad_pcb

## KiCad design 04_KiCad_Project/ESP_FPV_ATHUL_IOGROUPED.kicad_pcb (continued)

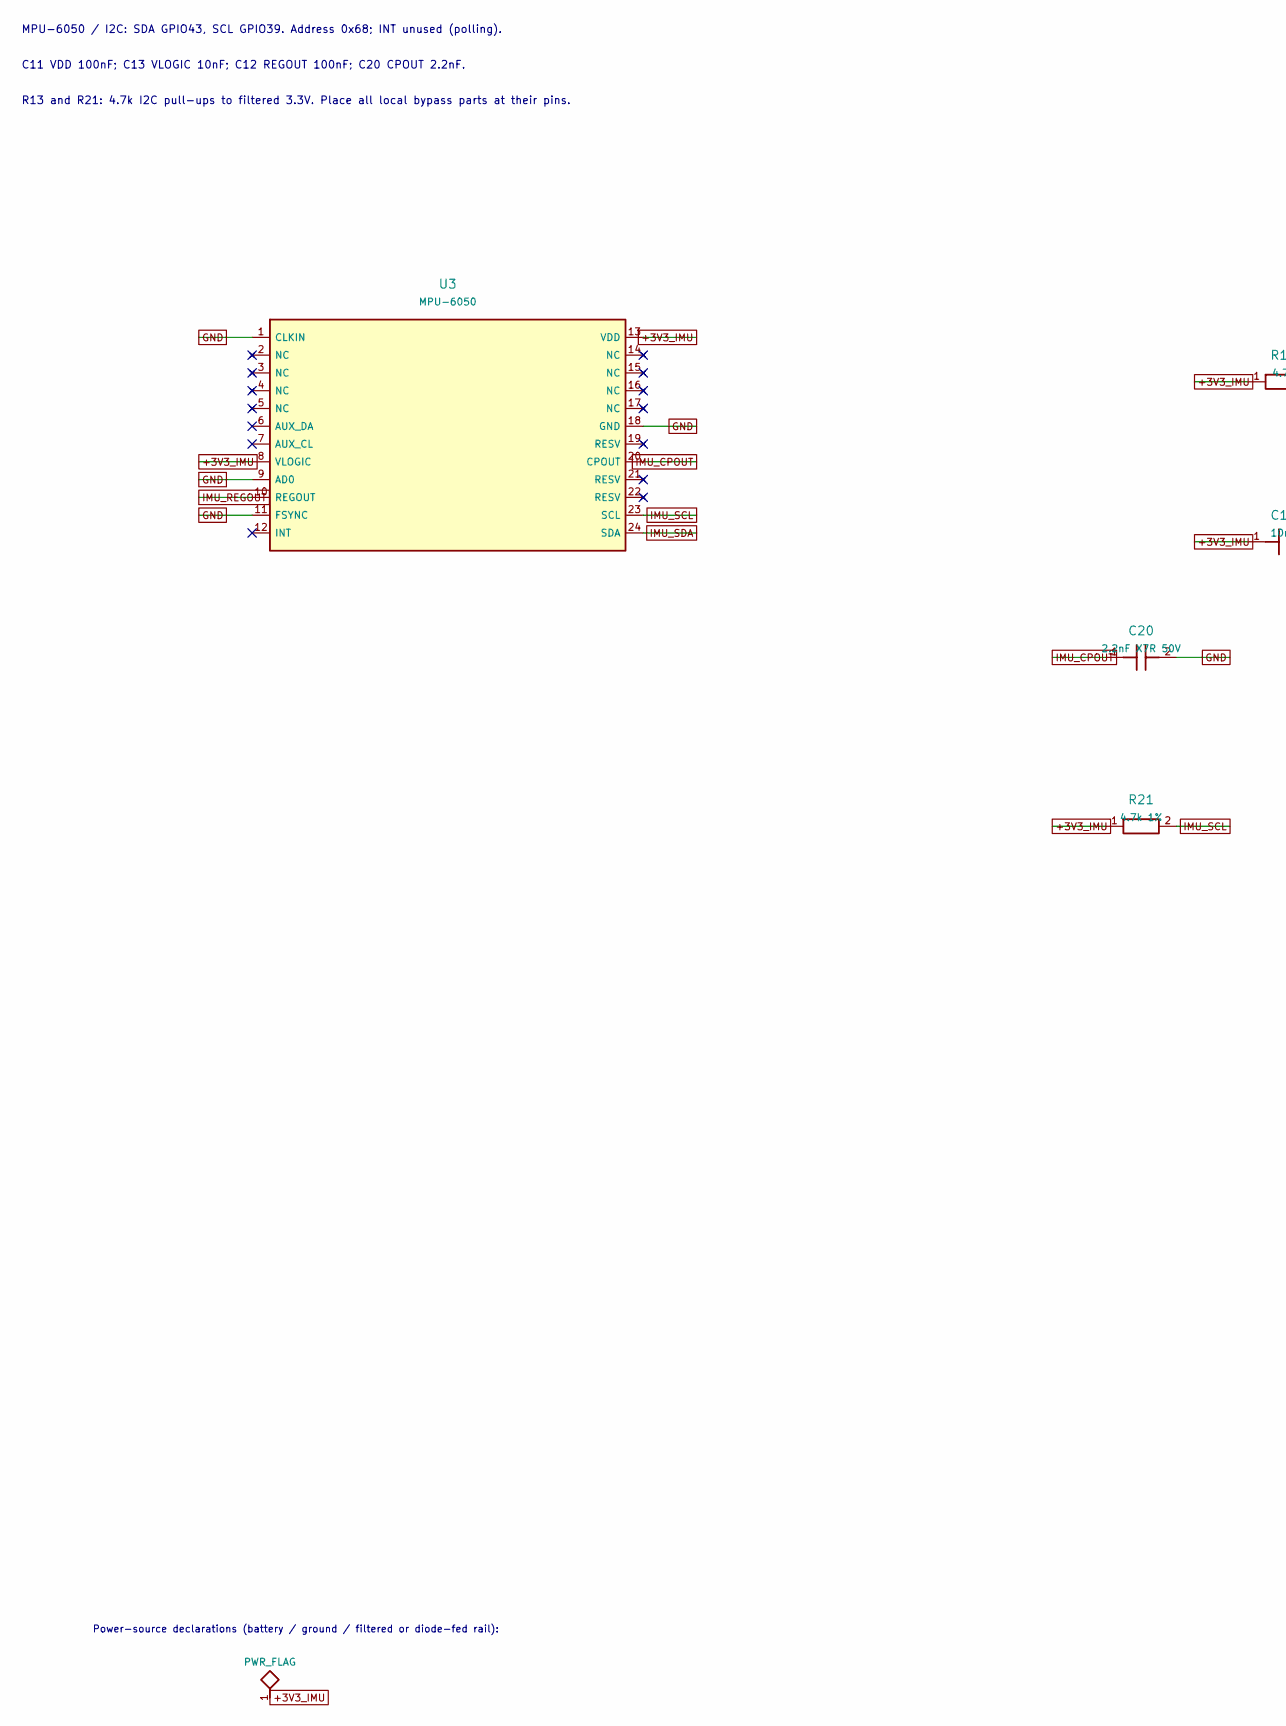
[picture p28: schematic imu.kicad_sch, MPU-6050 IMU, part in row 1, column 1]

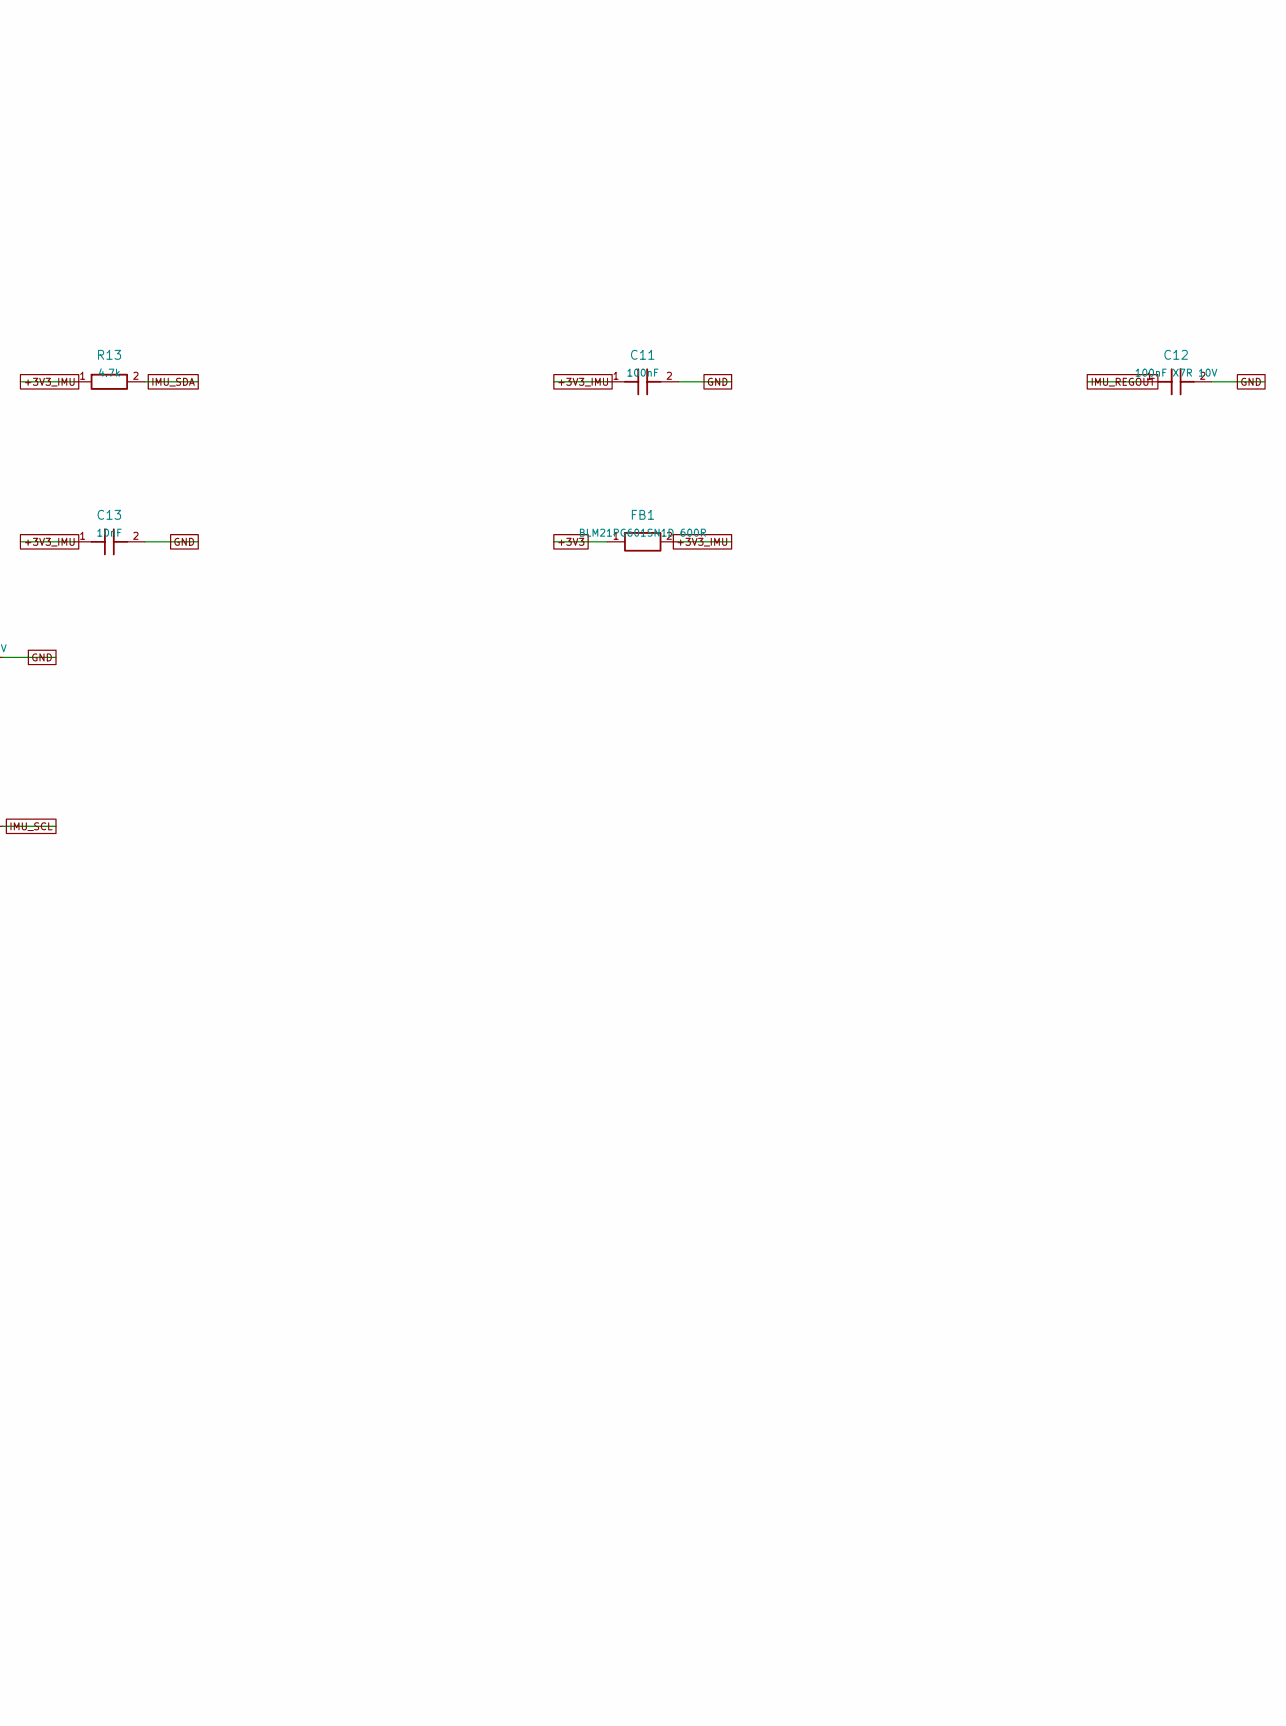
[picture p29: schematic imu.kicad_sch, MPU-6050 IMU, part in row 1, column 2]

Parts:
C11: 100nF; C_0805_2012Metric_Compact
C12: 100nF X7R 10V; C_0805_2012Metric_Compact
C13: 10nF; C_0805_2012Metric_Compact
C20: 2.2nF X7R 50V; RevK_Assembly_C20
FB1: BLM21PG601SN1D 600R; L_0805_2012Metric_Compact
R13: 4.7k; R_0805_2012Metric_Compact
R21: 4.7k 1%; R_0805_2012Metric_Compact
U3: MPU-6050; RevK_Assembly_U3

Connections:
+3V3: FB1.1; also elsewhere on the board
+3V3_IMU: C11.1, C13.1, FB1.2, R13.1, R21.1, U3.8 (VLOGIC), U3.13 (VDD)
GND: C11.2, C12.2, C13.2, C20.2, U3.1 (CLKIN), U3.9 (AD0), U3.11 (FSYNC), U3.18 (GND); also elsewhere on the board
IMU_CPOUT: C20.1, U3.20 (CPOUT)
IMU_REGOUT: C12.1, U3.10 (REGOUT)
IMU_SCL: R21.2, U3.23 (SCL); also elsewhere on the board
IMU_SDA: R13.2, U3.24 (SDA); also elsewhere on the board

Notes on the sheet:
Power-source declarations (battery / ground / filtered or diode-fed rail):
MPU-6050 / I2C: SDA GPIO43, SCL GPIO39. Address 0x68; INT unused (polling).
C11 VDD 100nF; C13 VLOGIC 10nF; C12 REGOUT 100nF; C20 CPOUT 2.2nF.
R13 and R21: 4.7k I2C pull-ups to filtered 3.3V. Place all local bypass parts at their pins.

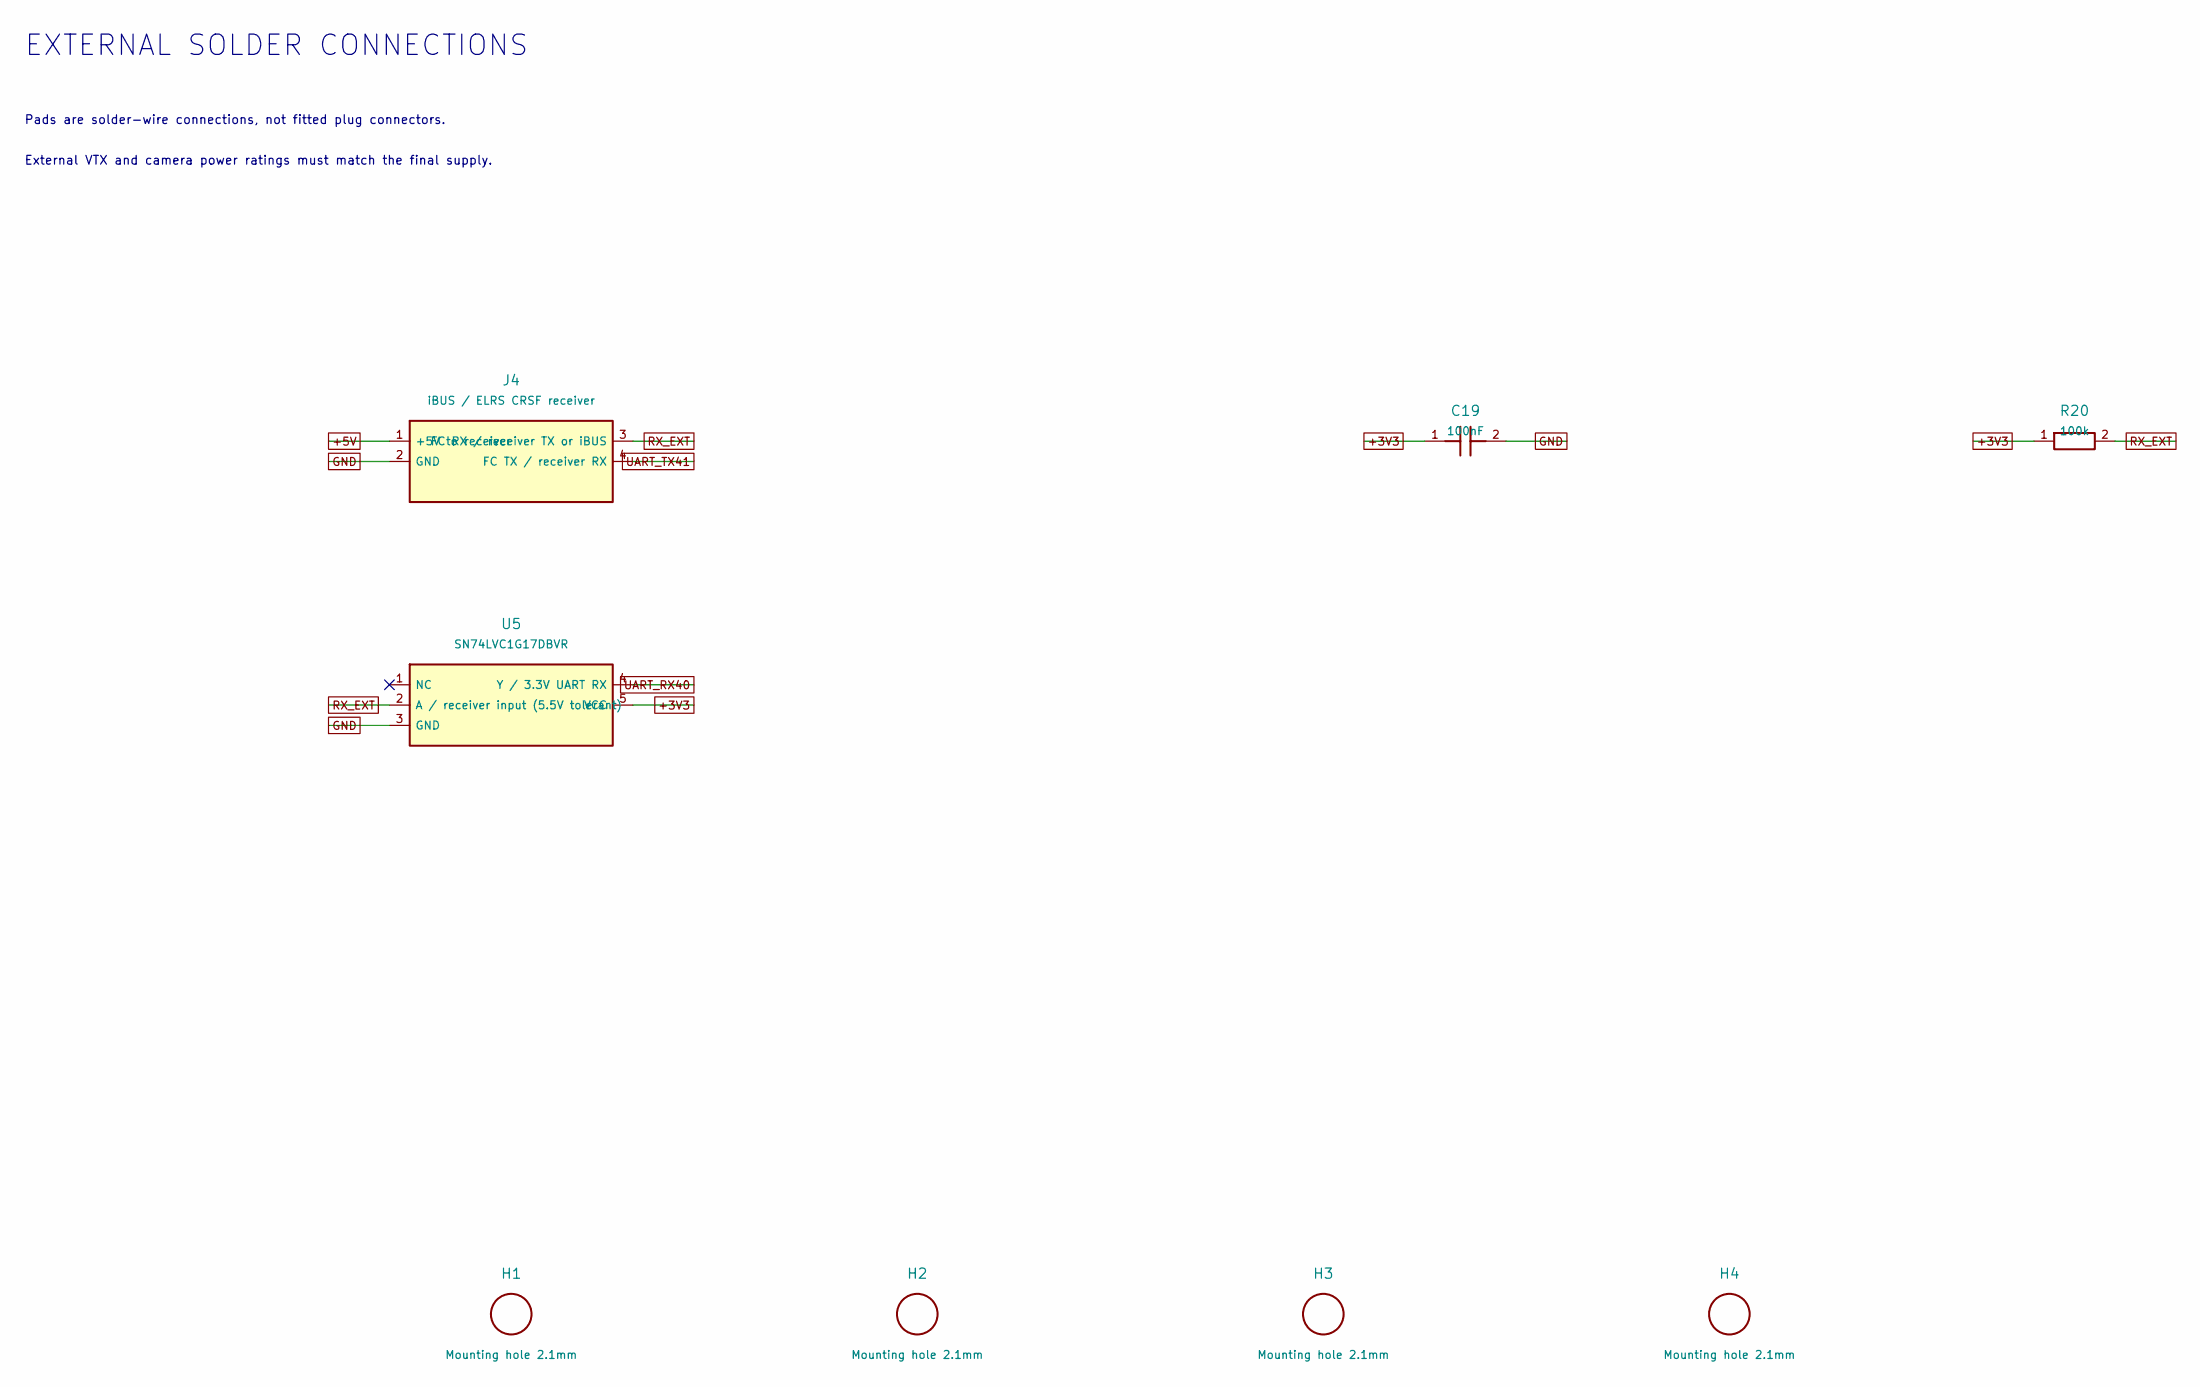
[picture p30: schematic connectors.kicad_sch, External I/O and mounting holes]

Parts:
C19: 100nF; C_0805_2012Metric_Compact
H1, H2, H3, H4: Mounting hole 2.1mm; Hole_2p1mm_3p6Head
J4: iBUS / ELRS CRSF receiver; Receiver_Pads_1p5
R20: 100k; R_0805_2012Metric_Compact
U5: SN74LVC1G17DBVR; Receiver_Buffer_SOT23_5

Connections:
+3V3: C19.1, R20.1, U5.5 (VCC); also elsewhere on the board
+5V: J4.1 (+5V to receiver); also elsewhere on the board
GND: C19.2, J4.2 (GND), U5.3 (GND); also elsewhere on the board
RX_EXT: J4.3 (FC RX / receiver TX or iBUS), R20.2, U5.2 (A / receiver input (5.5V tolerant))
UART_RX40: U5.4 (Y / 3.3V UART RX); also elsewhere on the board
UART_TX41: J4.4 (FC TX / receiver RX); also elsewhere on the board

Notes on the sheet:
EXTERNAL SOLDER CONNECTIONS
Pads are solder-wire connections, not fitted plug connectors.
External VTX and camera power ratings must match the final supply.

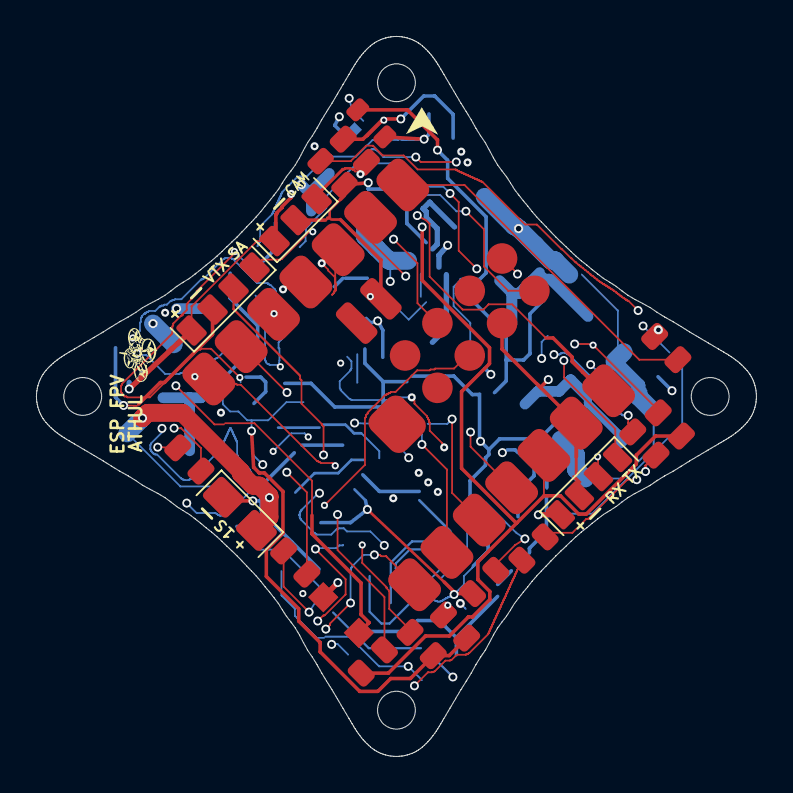
[picture p31: board ESP_FPV_ATHUL_IOGROUPED.kicad_pcb from above]

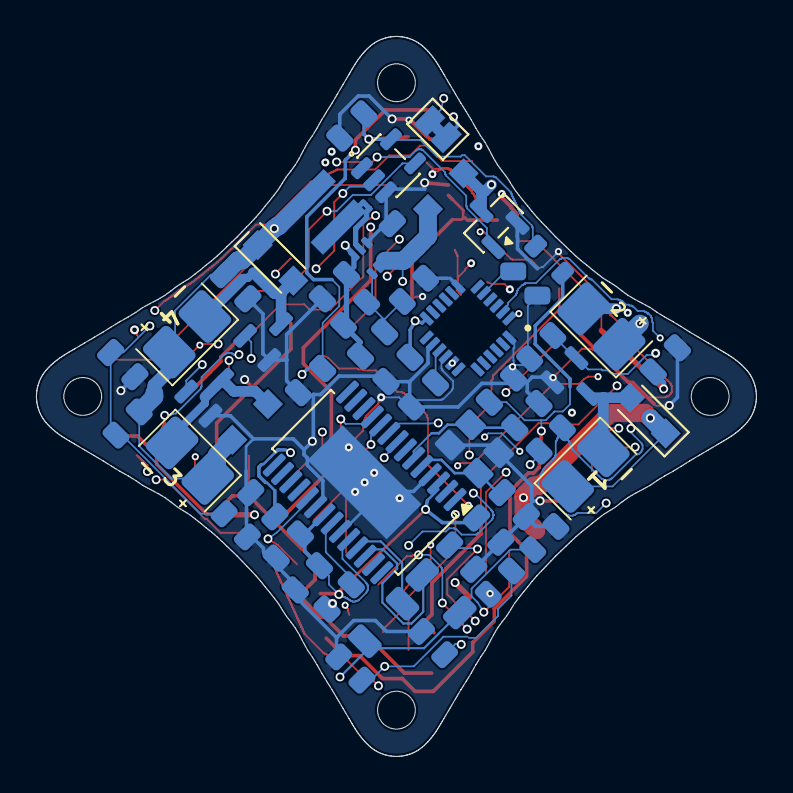
[picture p32: board ESP_FPV_ATHUL_IOGROUPED.kicad_pcb from below]

Board: 4 copper layers, 40.0 x 40.0 mm, 75 parts (52 on the bottom side), 47 nets.
