Athul24milu/ESPFC-WHOOP-/(commit log)

2026-11-10 Add MATRIX40 L2 PCB fabrication package and user documentation
    [ESP_FC_L2_BOM_All_75_References.csv, ESP_FC_L2_Purchase_BOM.xlsx, ESP_FPV_ATHUL_IOGROUPED.kicad_pcb, ESP_FPV_ATHUL_IOGROUPED.kicad_sch, XIAO-ESP32S3-centered.step, connectors.kicad_sch, controller.kicad_sch, imu.kicad_sch]
2026-11-10 Release L3 PCB with zero DRC warnings and fresh fabrication files
    [ESP_FPV_ATHUL_IOGROUPED.kicad_pcb]
2026-11-10 Restore original silkscreen while retaining corrected L3 routing
    [ESP_FPV_ATHUL_IOGROUPED.kicad_pcb]
